mikld86/GMTiredandForked/README.md

<p align="center">

<br />
  

[][cc-by-nc-sa]
[][sonar-url]
[][sonar-url]
[][sonar-url]

</p>

This project upgrades a Gaggia espresso machine with smart controls to improve your coffee-making experience. By adding a display and custom electronics, you can monitor and control the machine more easily.

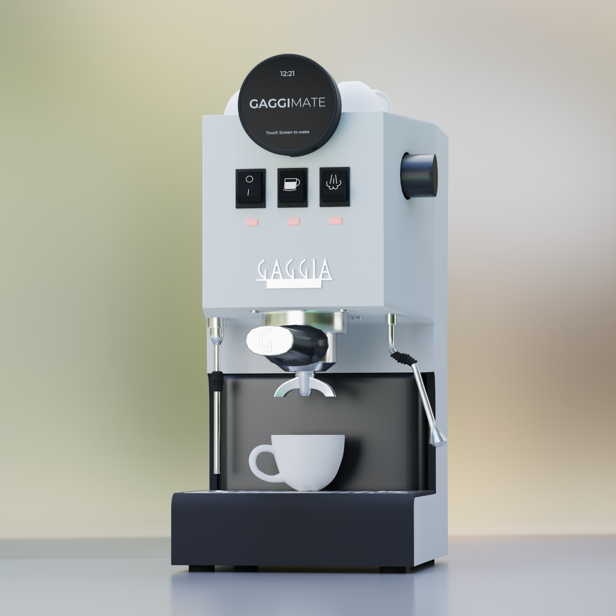
[picture p1: docs/assets/gaggimate-render.png]
Gaggia Classic Installation


## Features

- **Temperature Control**: Monitor the boiler temperature to ensure optimal brewing conditions.
- **Brew timer**: Set a target duration and run the brewing for the specific time.
- **Steam and Hot Water mode**: Control the pump and valve to run the respective task.
- **Safety Features**: Automatic shutoff if the system becomes unresponsive or overheats.
- **User Interface**: Simple, intuitive display to control and monitor the machine.

## Screenshots and Images

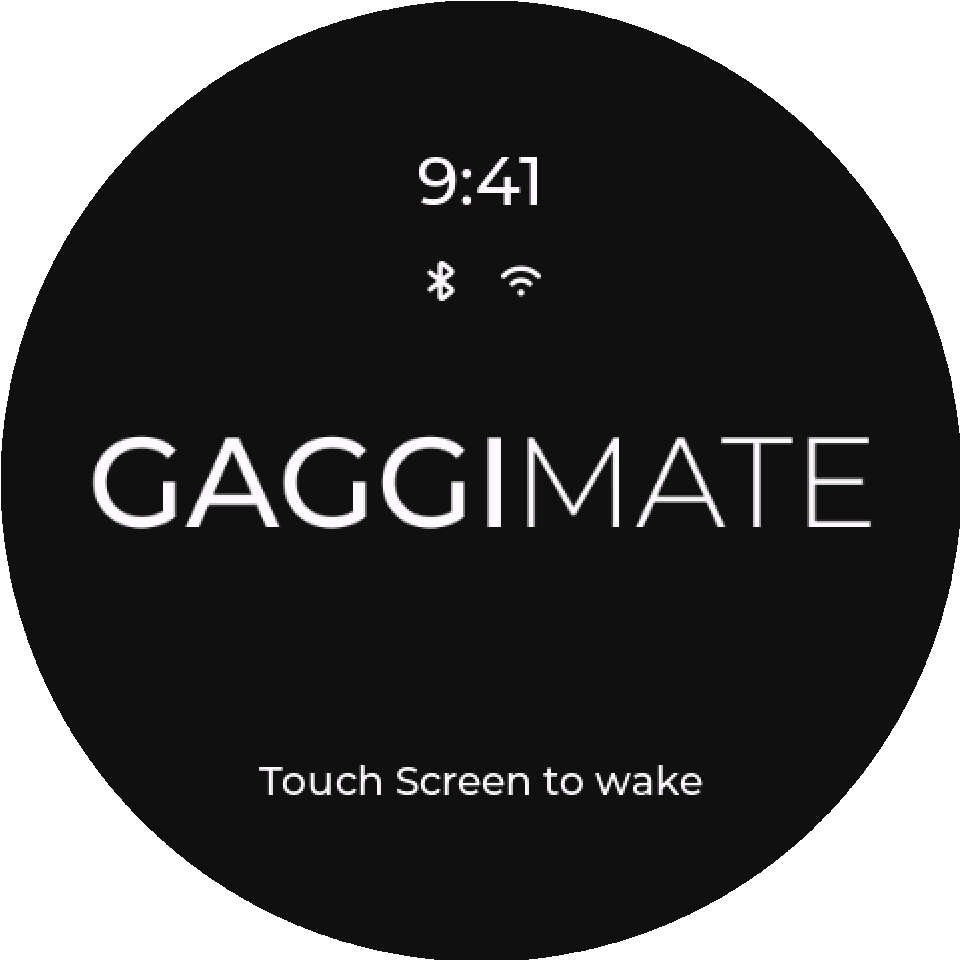
[picture p2: docs/assets/standby-screen.png]
Standby Screen

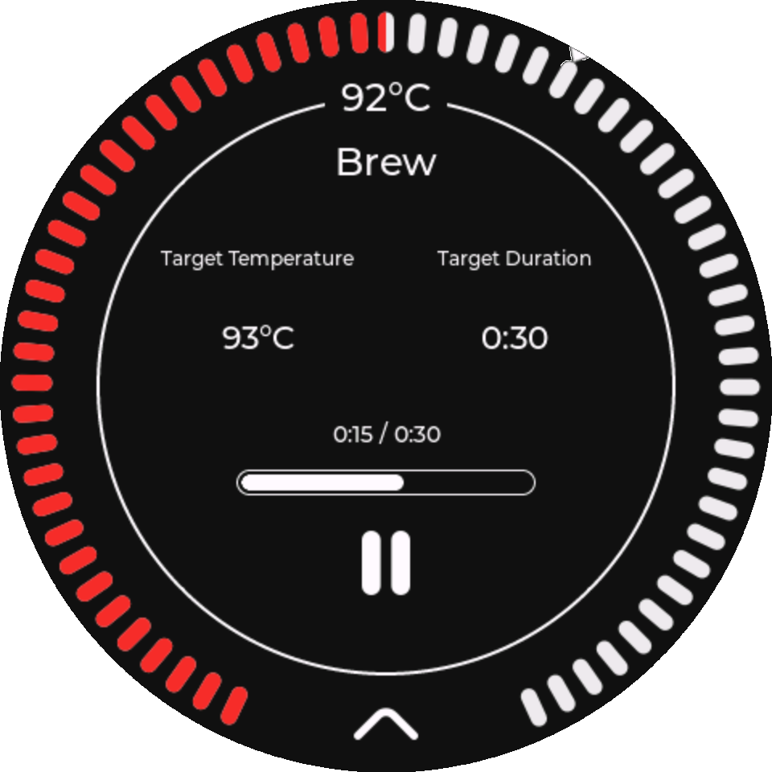
[picture p3: docs/assets/brew-screen.png]
Brew Screen

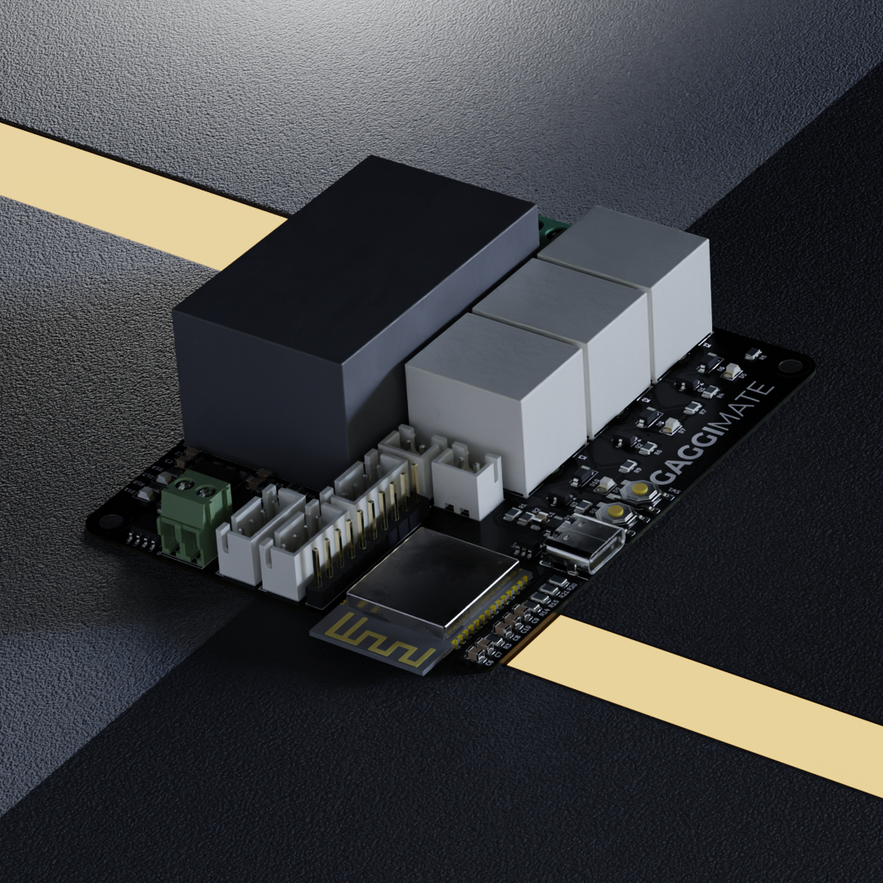
[picture p4: docs/assets/pcb_render.jpg]
PCB Render


### How to buy

The shop is now open for preorders and you can buy your kit on https://shop.gaggimate.eu/

## How It Works

The display allows you to control the espresso machine and see live temperature updates. If the machine becomes unresponsive or the temperature goes too high, it will automatically turn off for safety.

## Docs

The docs were moved to [https://gaggimate.eu/](https://gaggimate.eu/). You can find all sourcing and assembly information there.
Additional documentation for the WebSocket API can be found in [docs/websocket-api.yaml](docs/websocket-api.yaml).

## License

This work is licensed under CC BY-NC-SA 4.0. To view a copy of this license, visit https://creativecommons.org/licenses/by-nc-sa/4.0/

[sonar-violations]: https://img.shields.io/sonar/blocker_violations/jniebuhr_gaggimate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
[sonar-shield]: https://img.shields.io/sonar/quality_gate/jniebuhr_gaggimate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
[sonar-tech-debt]: https://img.shields.io/sonar/tech_debt/jniebuhr_gaggimate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
[sonar-url]: https://sonarcloud.io/project/overview?id=jniebuhr_gaggimate
[cc-by-nc-sa]: http://creativecommons.org/licenses/by-nc-sa/4.0/
[cc-by-nc-sa-image]: https://licensebuttons.net/l/by-nc-sa/4.0/88x31.png
[cc-by-nc-sa-shield]: https://img.shields.io/badge/License-CC%20BY--NC--SA%204.0-lightgrey.svg?style=for-the-badge
