mikld86/GMTiredandForked/docs/assets/gaggimate-transparent.png

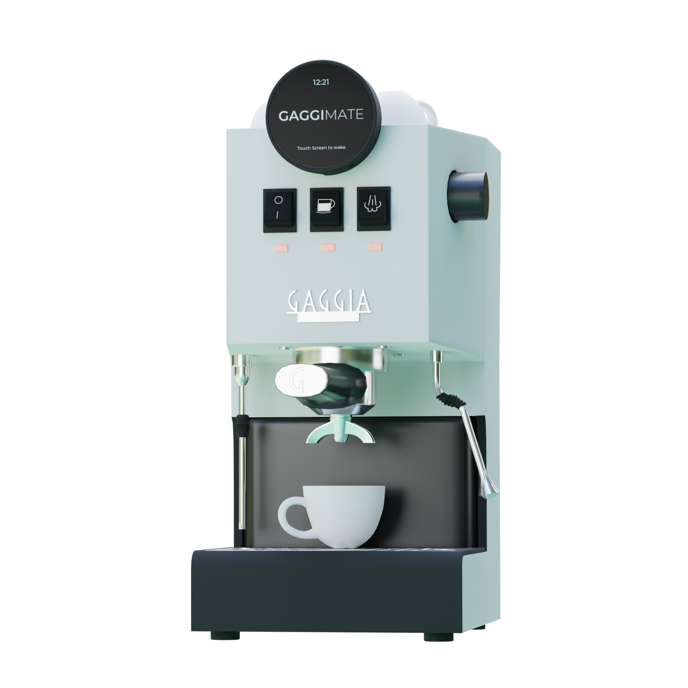
docs/assets/gaggimate-transparent.png
