mikld86/GMTiredandForked/docs/assets/menu-screen.png

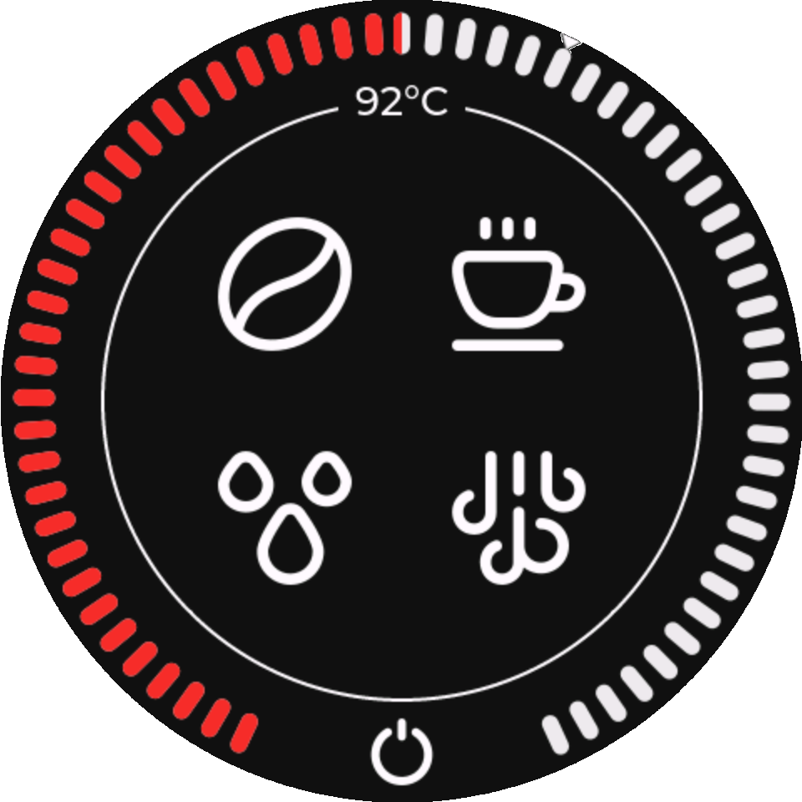
docs/assets/menu-screen.png
