mikld86/GMTiredandForked/docs/assets/pcb_top.png

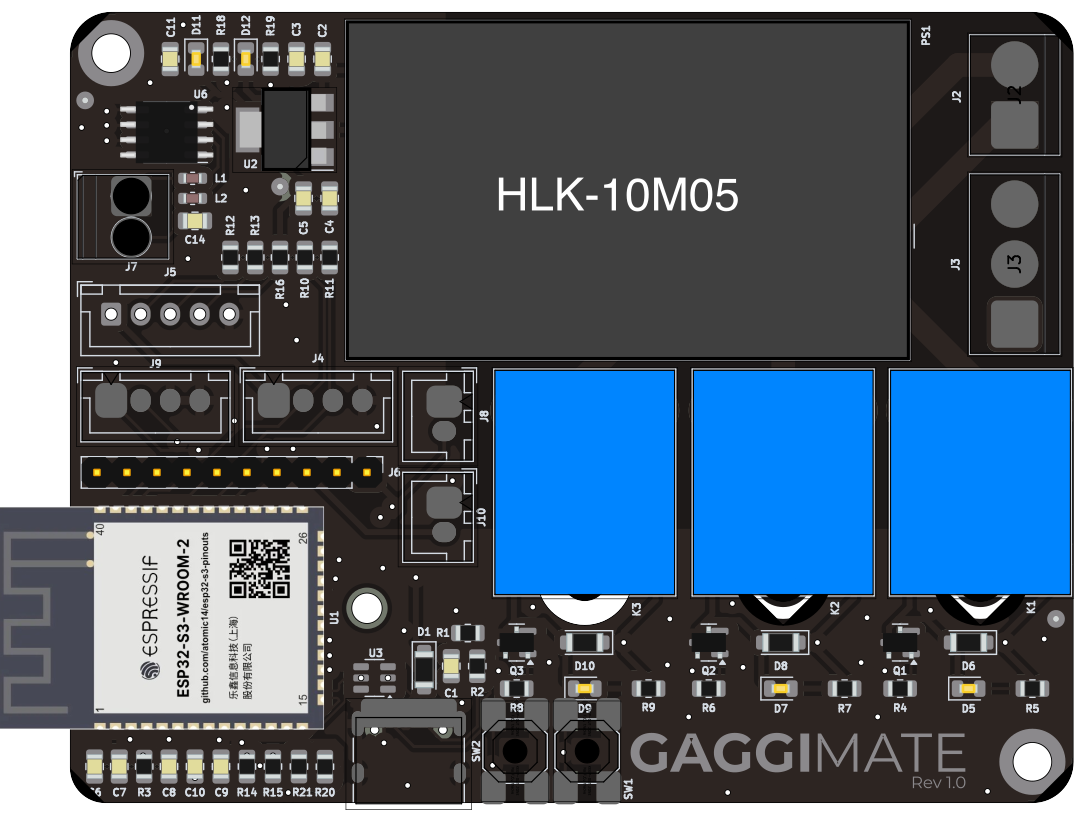
docs/assets/pcb_top.png
