mikld86/GMTiredandForked/docs/diagrams/classic.png

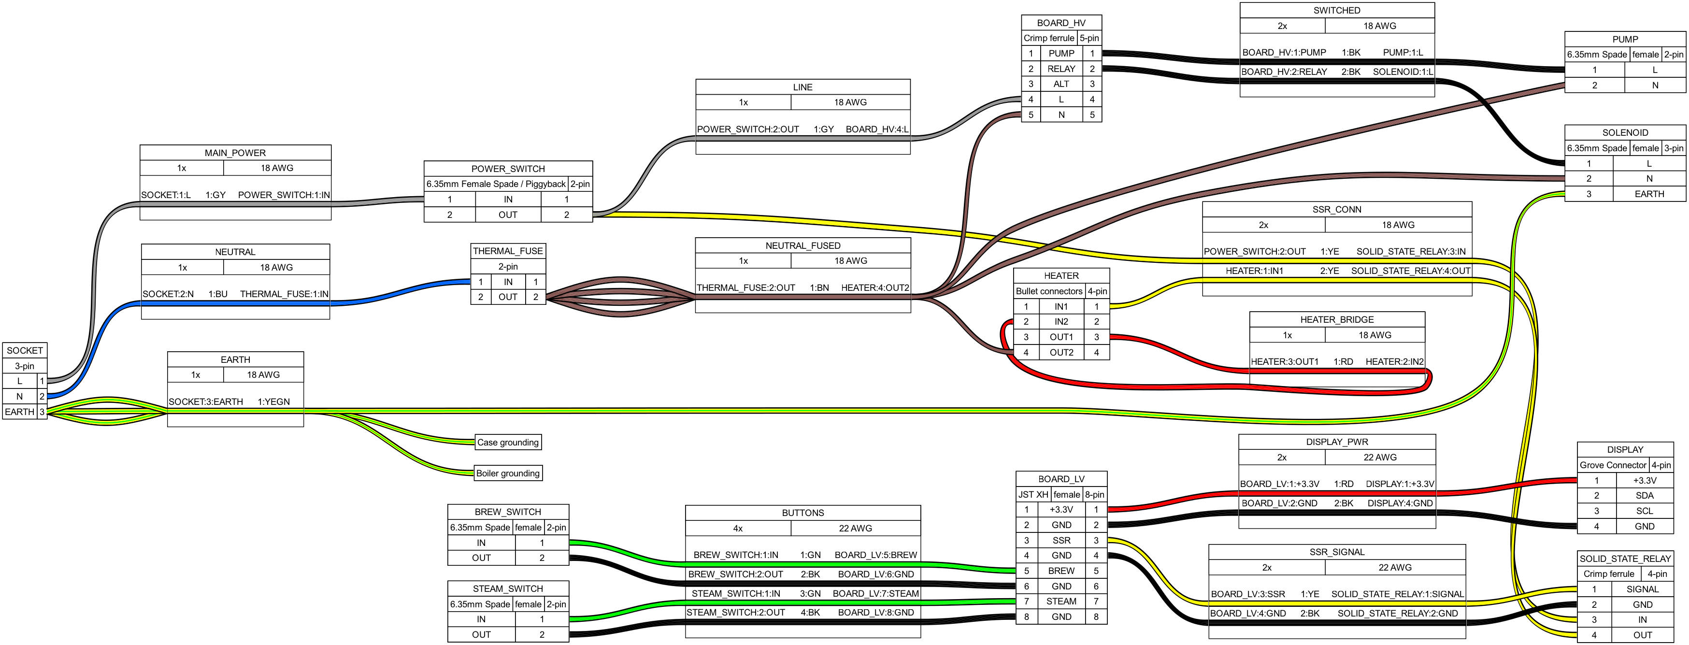
docs/diagrams/classic.png
