mikld86/GMTiredandForked/docs/diagrams/classicpro.png

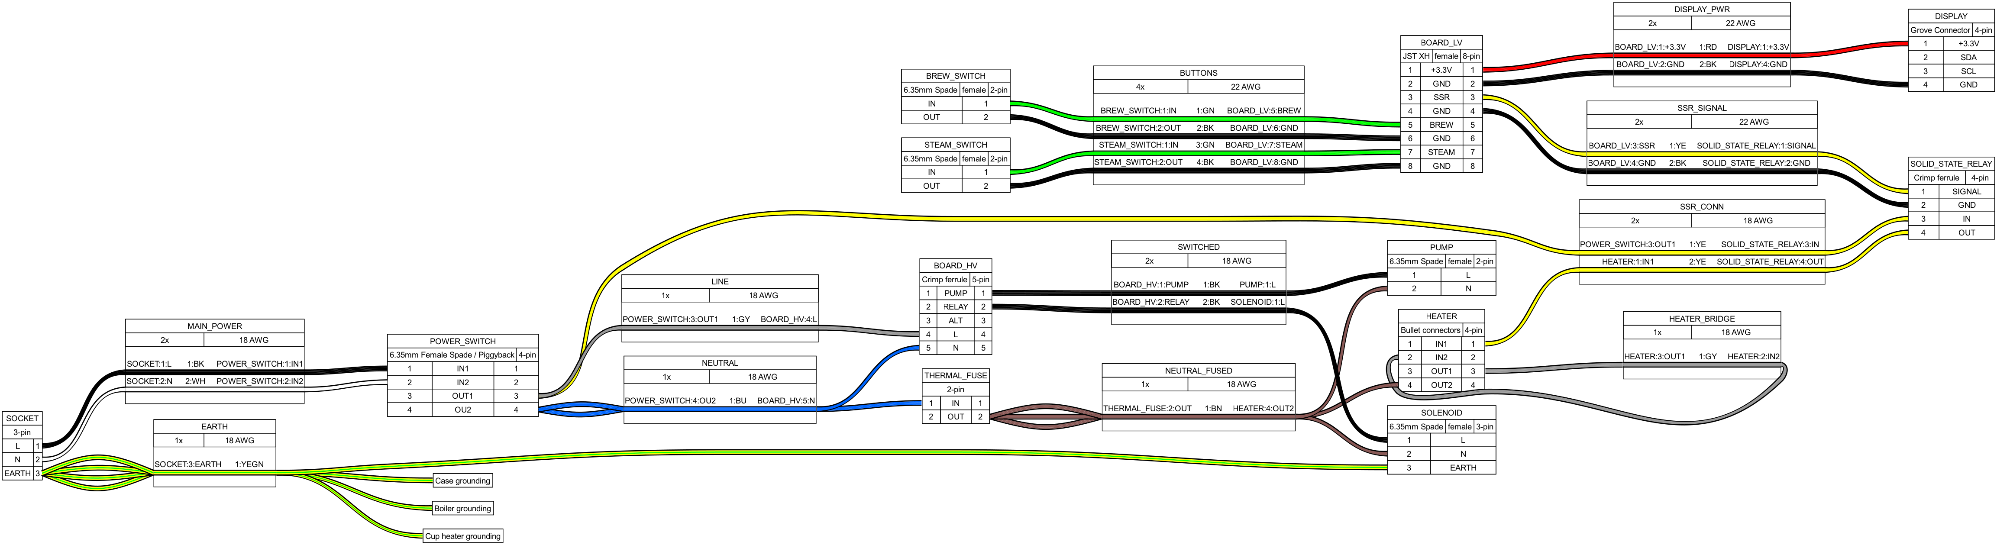
docs/diagrams/classicpro.png
