mikld86/GMTiredandForked/ui/assets/gauge-fill.png

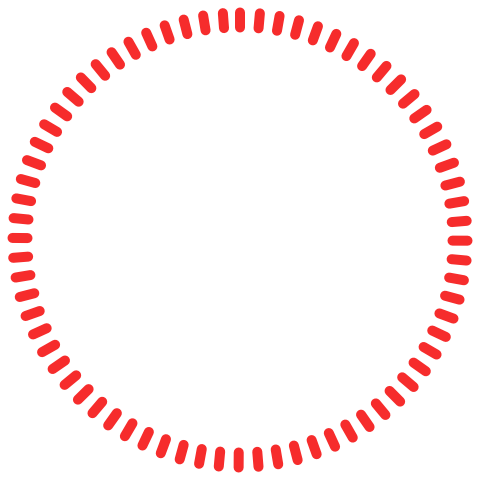
ui/assets/gauge-fill.png
