mikld86/GMTiredandForked/ui/assets/Untitled.png

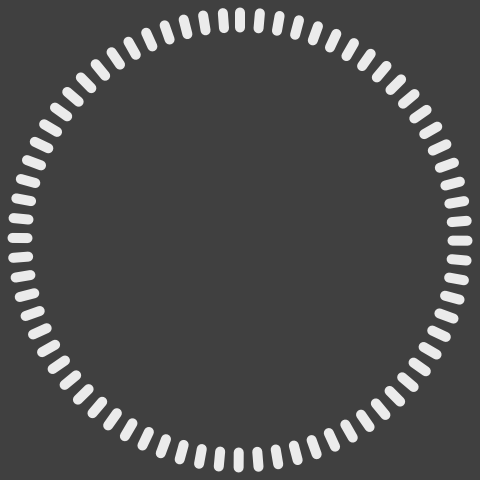
ui/assets/Untitled.png
