mikld86/GMTiredandForked/cad/Angled Display Case.step

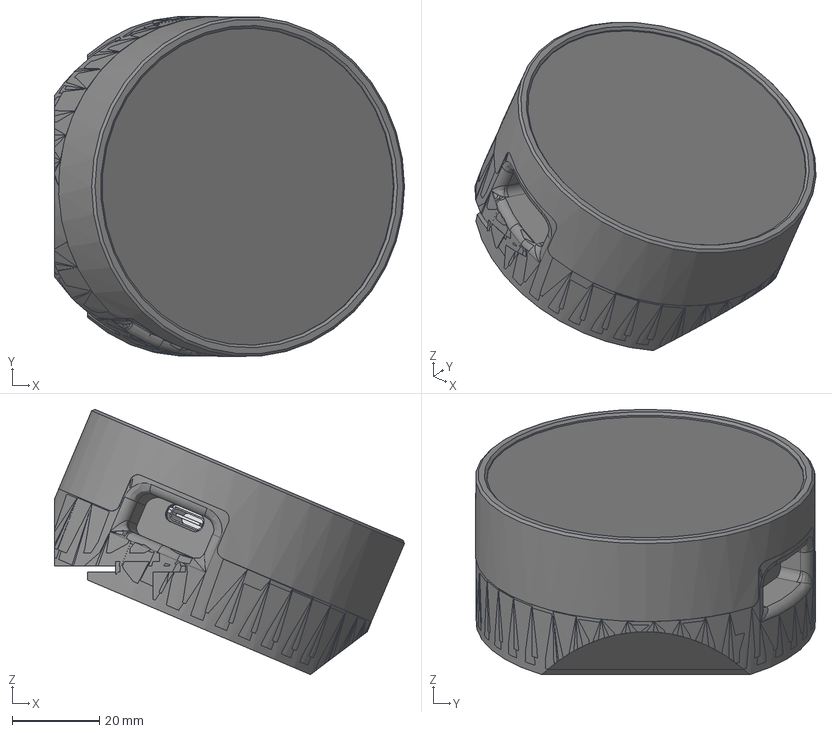
[picture p12: CAD file, 2025-01-10]
cad/Angled Display Case.step
80.1 x 77.9 x 60.7 mm
Case Front
Case Back Rancilio
LCD_BH021
T_RGB-V1_0
T_RGB_COVA
Case Back GCP
Case Back GC
