mikld86/GMTiredandForked/stls/display/case_back_rancilio_silvia.stl

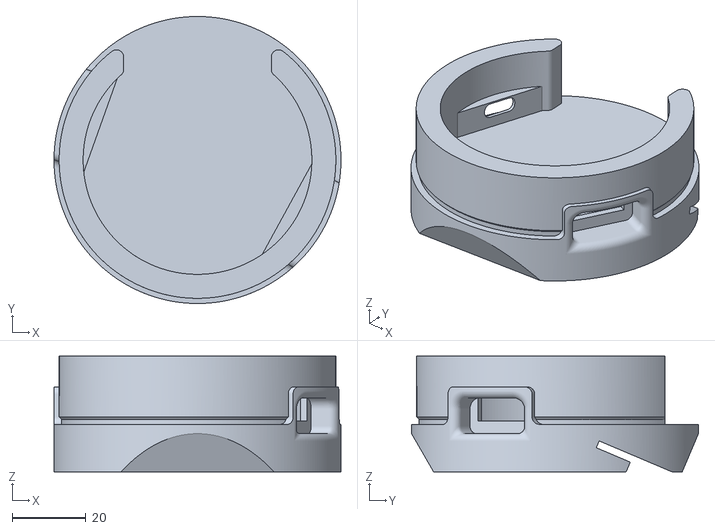
[picture p13: CAD file, 2025-04-02]
stls/display/case_back_rancilio_silvia.stl
77.8 x 77.8 x 31.4
