mikld86/GMTiredandForked/stls/lego/electronics_mount.stl

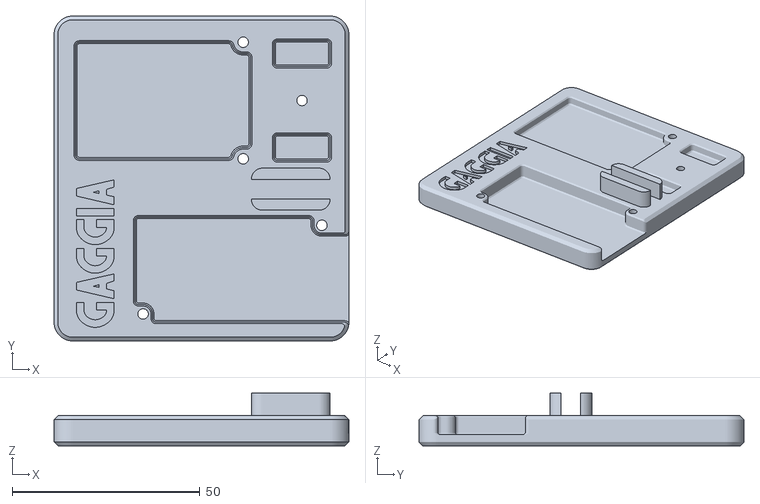
[picture p14: CAD file, 2024-11-18]
stls/lego/electronics_mount.stl
78.5 x 86.5 x 14.0
