mikld86/GMTiredandForked/stls/pcb/gaggimate-pro-rev1/pcb_cover_clipped_[support].stl

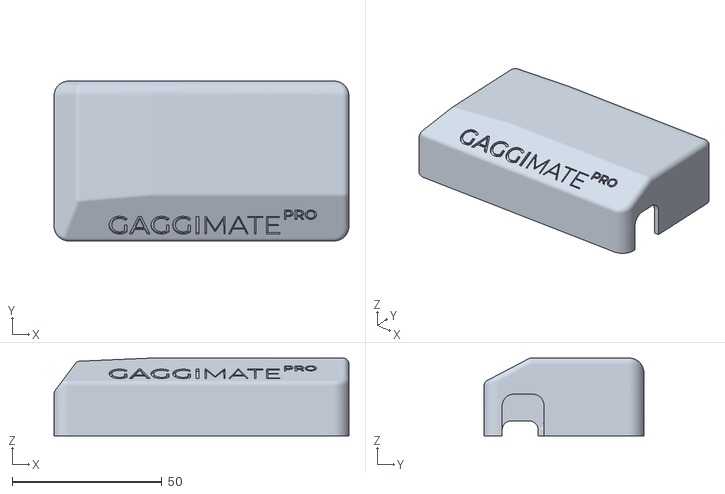
[picture p15: CAD file, 2025-04-22]
stls/pcb/gaggimate-pro-rev1/pcb_cover_clipped_[support].stl
98.4 x 53.4 x 26.0
