mikld86/GMTiredandForked/stls/pcb/gaggimate-standard-rev2/pcb_cover_clipped_[support].stl

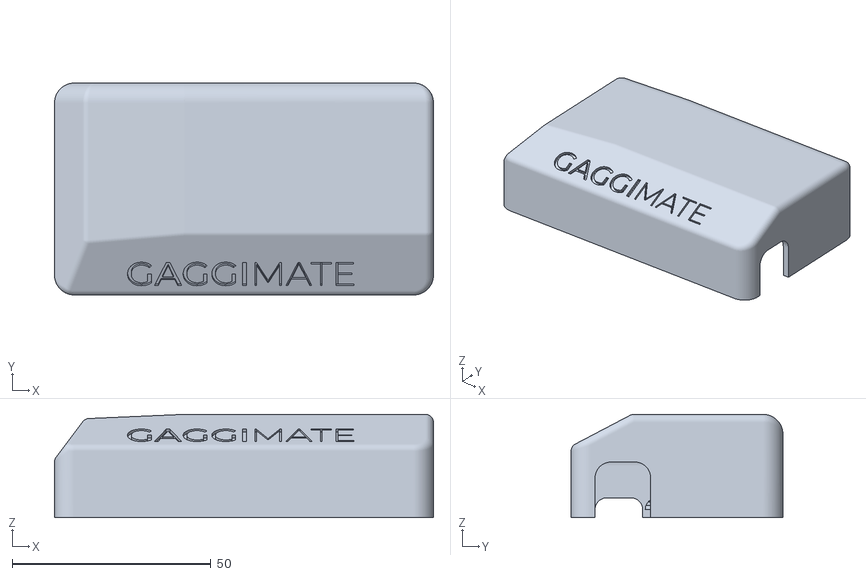
[picture p16: CAD file, 2025-04-22]
stls/pcb/gaggimate-standard-rev2/pcb_cover_clipped_[support].stl
95.4 x 53.4 x 26.0
