mikld86/GMTiredandForked/stls/display/case_front.stl

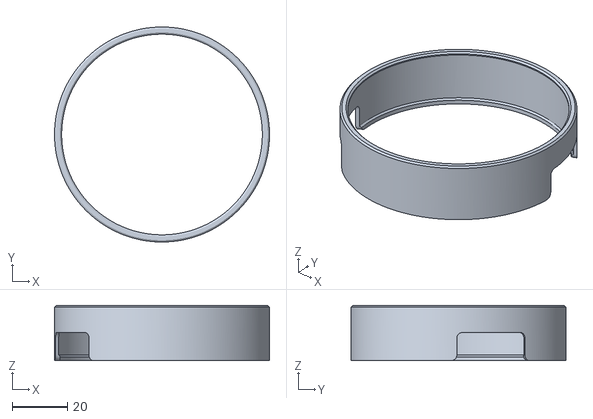
[picture p17: CAD file, 2025-04-02]
stls/display/case_front.stl
77.8 x 77.8 x 20.0
