mikld86/GMTiredandForked/stls/pcb/gaggimate-pro-rev1/pcb_base_clipped.stl

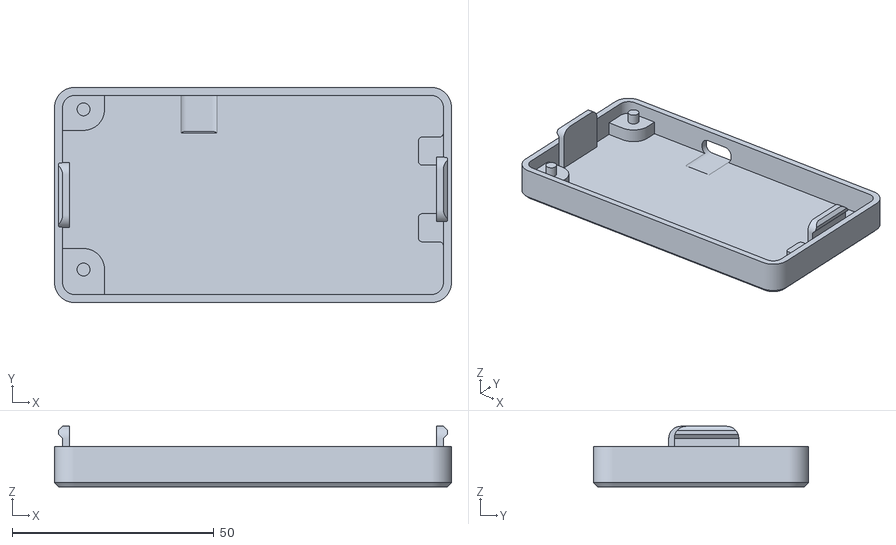
[picture p18: CAD file, 2025-04-22]
stls/pcb/gaggimate-pro-rev1/pcb_base_clipped.stl
98.4 x 53.4 x 15.0
