mikld86/GMTiredandForked/stls/pcb/gaggimate-standard-rev2/pcb_base_clipped.stl

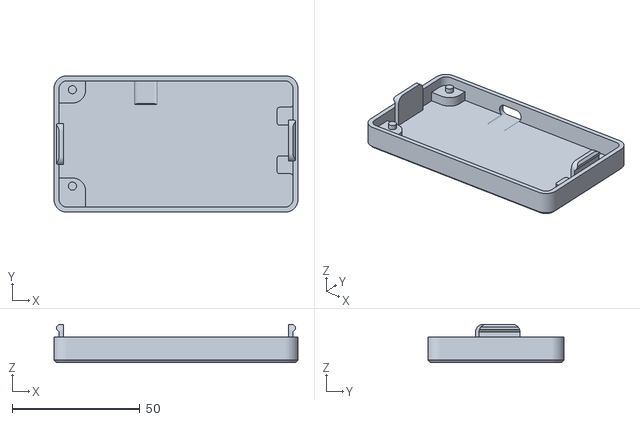
[picture p19: CAD file, 2025-04-22]
stls/pcb/gaggimate-standard-rev2/pcb_base_clipped.stl
95.4 x 53.4 x 15.0
