mikld86/GMTiredandForked/stls/display/Alternative backplate/case_back.stl

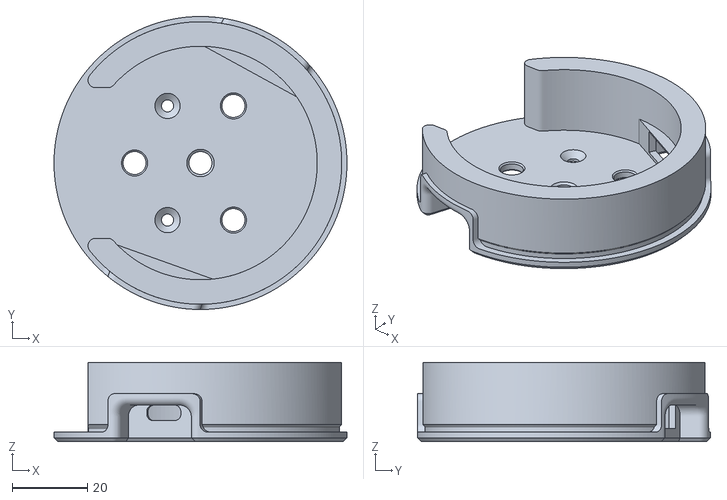
[picture p20: CAD file, 2024-11-18]
stls/display/Alternative backplate/case_back.stl
77.8 x 77.8 x 21.0
