mikld86/GMTiredandForked/stls/display/case_back_gaggia_classic_pro.stl

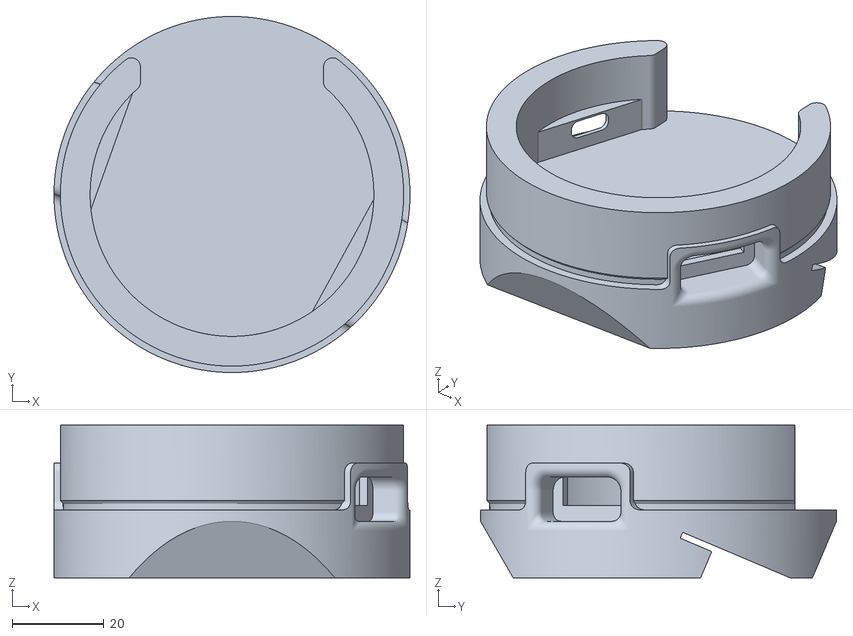
[picture p21: CAD file, 2025-04-02]
stls/display/case_back_gaggia_classic_pro.stl
77.8 x 77.8 x 33.4
