mikld86/GMTiredandForked/cad/Display Case.step

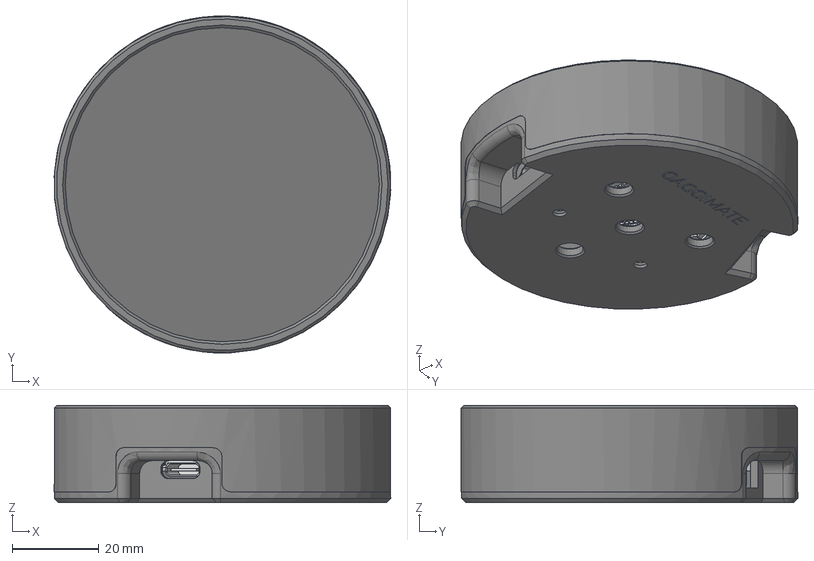
[picture p22: CAD file, 2024-11-26]
cad/Display Case.step
77.8 x 77.9 x 22.5 mm
Case Front
Case Back
LCD_BH021
T_RGB-V1_0
T_RGB_COVA
