mikld86/GMTiredandForked/stls/display/case_back_gaggia_classic.stl

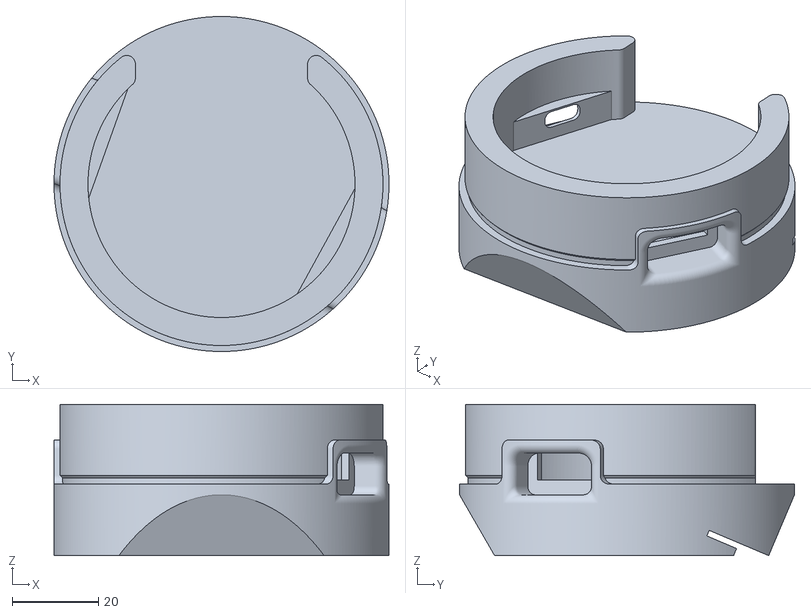
[picture p23: CAD file, 2025-04-02]
stls/display/case_back_gaggia_classic.stl
77.8 x 77.8 x 35.1
