mikld86/GMTiredandForked/stls/pcb/gaggimate-standard-rev1/pcb_clipped_cover.stl

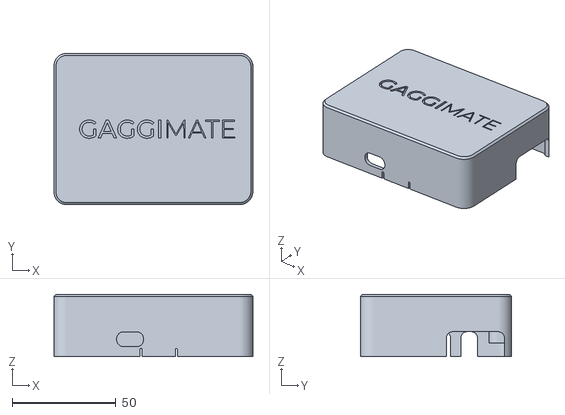
[picture p24: CAD file, 2024-12-03, an earlier design]
stls/pcb/gaggimate-standard-rev1/pcb_clipped_cover.stl
96.0 x 73.0 x 30.0
