mikld86/GMTiredandForked/stls/pcb/gaggimate-standard-rev1/pcb_clipped_base.stl

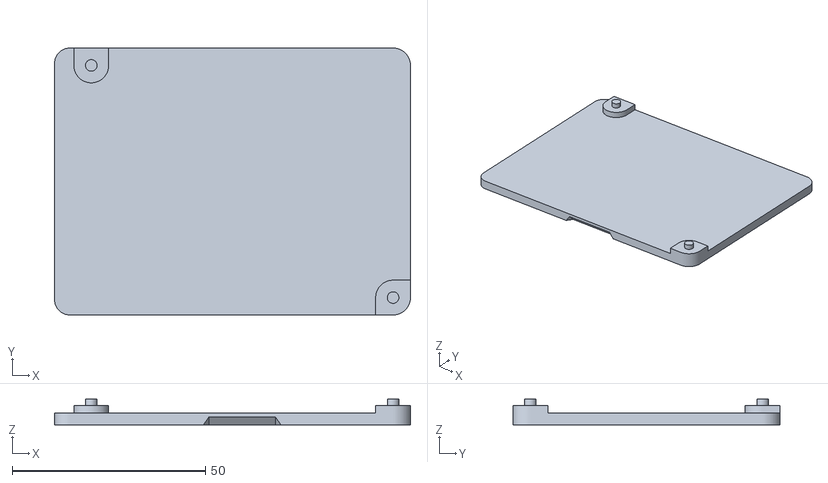
[picture p25: CAD file, 2024-12-03, an earlier design]
stls/pcb/gaggimate-standard-rev1/pcb_clipped_base.stl
92.0 x 69.0 x 6.60
