mikld86/GMTiredandForked/(list of files, cad)

Other CAD files:
stls/display/Alternative backplate/Case-back-withScrewholes.stl.stl
cad/Screen Backplate - no screwholes.step
stls/display/Alternative backplate/Case-back-noScrewholes.stl
cad/Screen Backplate - With screwholes.step
stls/pcb/gaggimate-standard-rev1/pcb_base.stl
stls/pcb/gaggimate-standard-rev1/pcb_cover.stl
