mikld86/GMTiredandForked/pcb/expansion-template/gaggimate-expansion-template.kicad_pcb

## KiCad design pcb/expansion-template/gaggimate-expansion-template.kicad_pcb (2025-02-04)

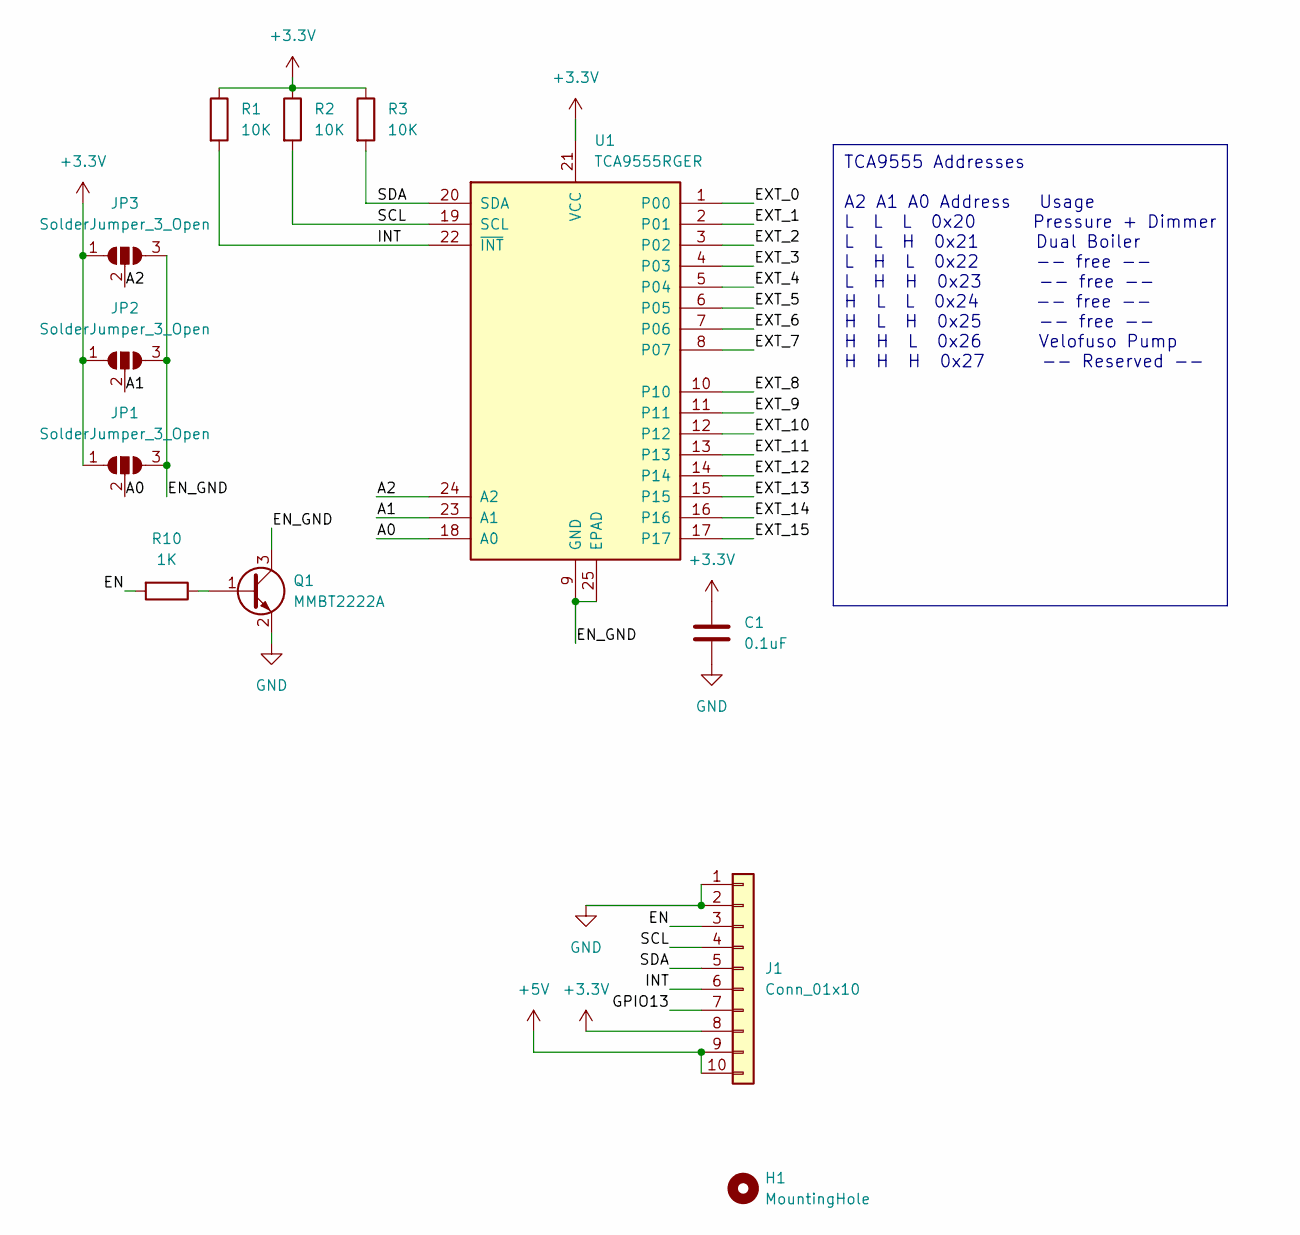
[picture p26: schematic gaggimate-expansion-template.kicad_sch]

Parts:
C1: 0.1uF; C_0603_1608Metric
H1: MountingHole; MountingHole_2.7mm_M2.5
J1: Conn_01x10; PinSocket_1x10_P2.54mm_Vertical
JP1, JP2, JP3: SolderJumper_3_Open; SolderJumper-3_P1.3mm_Open_RoundedPad1.0x1.5mm
Q1: MMBT2222A; SOT-23
R1, R2, R3: 10K; R_0603_1608Metric
R10: 1K; R_0603_1608Metric
U1: TCA9555RGER; VQFN-24-1EP_4x4mm_P0.5mm_EP2.45x2.45mm

Connections:
+3.3V: C1.1, J1.8, JP1.1 (A), JP2.1 (A), JP3.1 (A), R1.1, R2.1, R3.1, U1.21 (VCC)
+5V: J1.9, J1.10
/A0: JP1.2 (C), U1.18 (A0)
/A1: JP2.2 (C), U1.23 (A1)
/A2: JP3.2 (C), U1.24 (A2)
/EN: J1.3, R10.2
/EN_GND: JP1.3 (B), JP2.3 (B), JP3.3 (B), Q1.3 (C), U1.9 (GND), U1.25 (EPAD)
/EXT_0: U1.1 (P00)
/EXT_1: U1.2 (P01)
/EXT_2: U1.3 (P02)
/EXT_3: U1.4 (P03)
/EXT_4: U1.5 (P04)
/EXT_5: U1.6 (P05)
/EXT_6: U1.7 (P06)
/EXT_7: U1.8 (P07)
/EXT_8: U1.10
/EXT_9: U1.11
/EXT_10: U1.12
/EXT_11: U1.13
/EXT_12: U1.14
/EXT_13: U1.15
/EXT_14: U1.16
/EXT_15: U1.17
/GPIO13: J1.7
/INT: J1.6, R1.2, U1.22 (~INT)
/SCL: J1.4, R2.2, U1.19 (SCL)
/SDA: J1.5, R3.2, U1.20 (SDA)
GND: C1.2, J1.1, J1.2, Q1.2 (E)
unnamed: Q1.1 (B), R10.1

Notes on the sheet:
TCA9555 Addresses A2 A1 A0 Address Usage L L L 0x20 Pressure + Dimmer L L H 0x21 Dual Boiler L H L 0x22 -- free -- L H H 0x23 -- free -- H L L 0x24 -- free -- H L H 0x25 -- free -- H H L 0x26 Velofuso Pump H H H 0x27 -- Reserved --

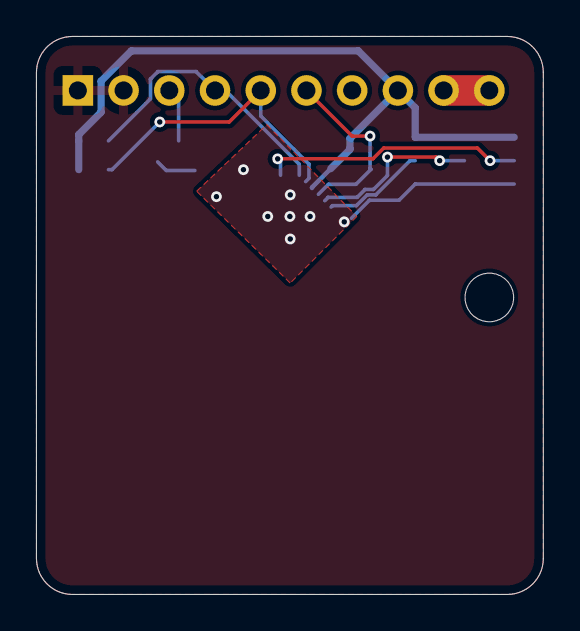
[picture p27: board gaggimate-expansion-template.kicad_pcb from above]

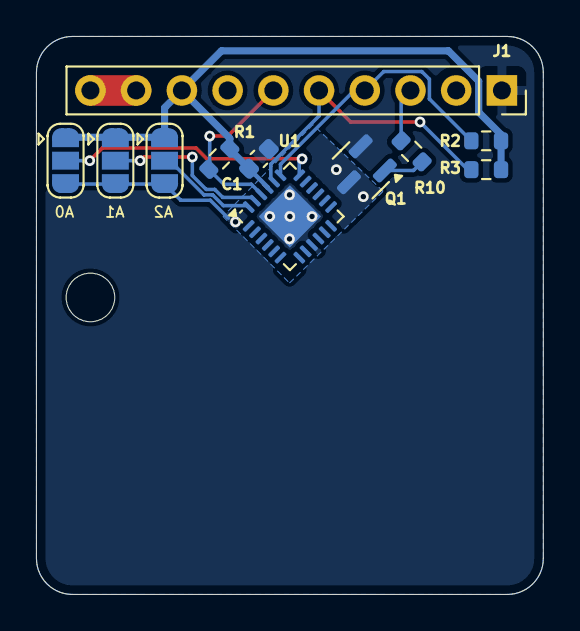
[picture p28: board gaggimate-expansion-template.kicad_pcb from below]

Board: 2 copper layers, 28.2 x 31.0 mm, 12 parts (11 on the bottom side), 12 nets.
