mikld86/GMTiredandForked/pcb/Gaggimate.kicad_pcb

## KiCad design pcb/Gaggimate.kicad_pcb (2024-11-24)

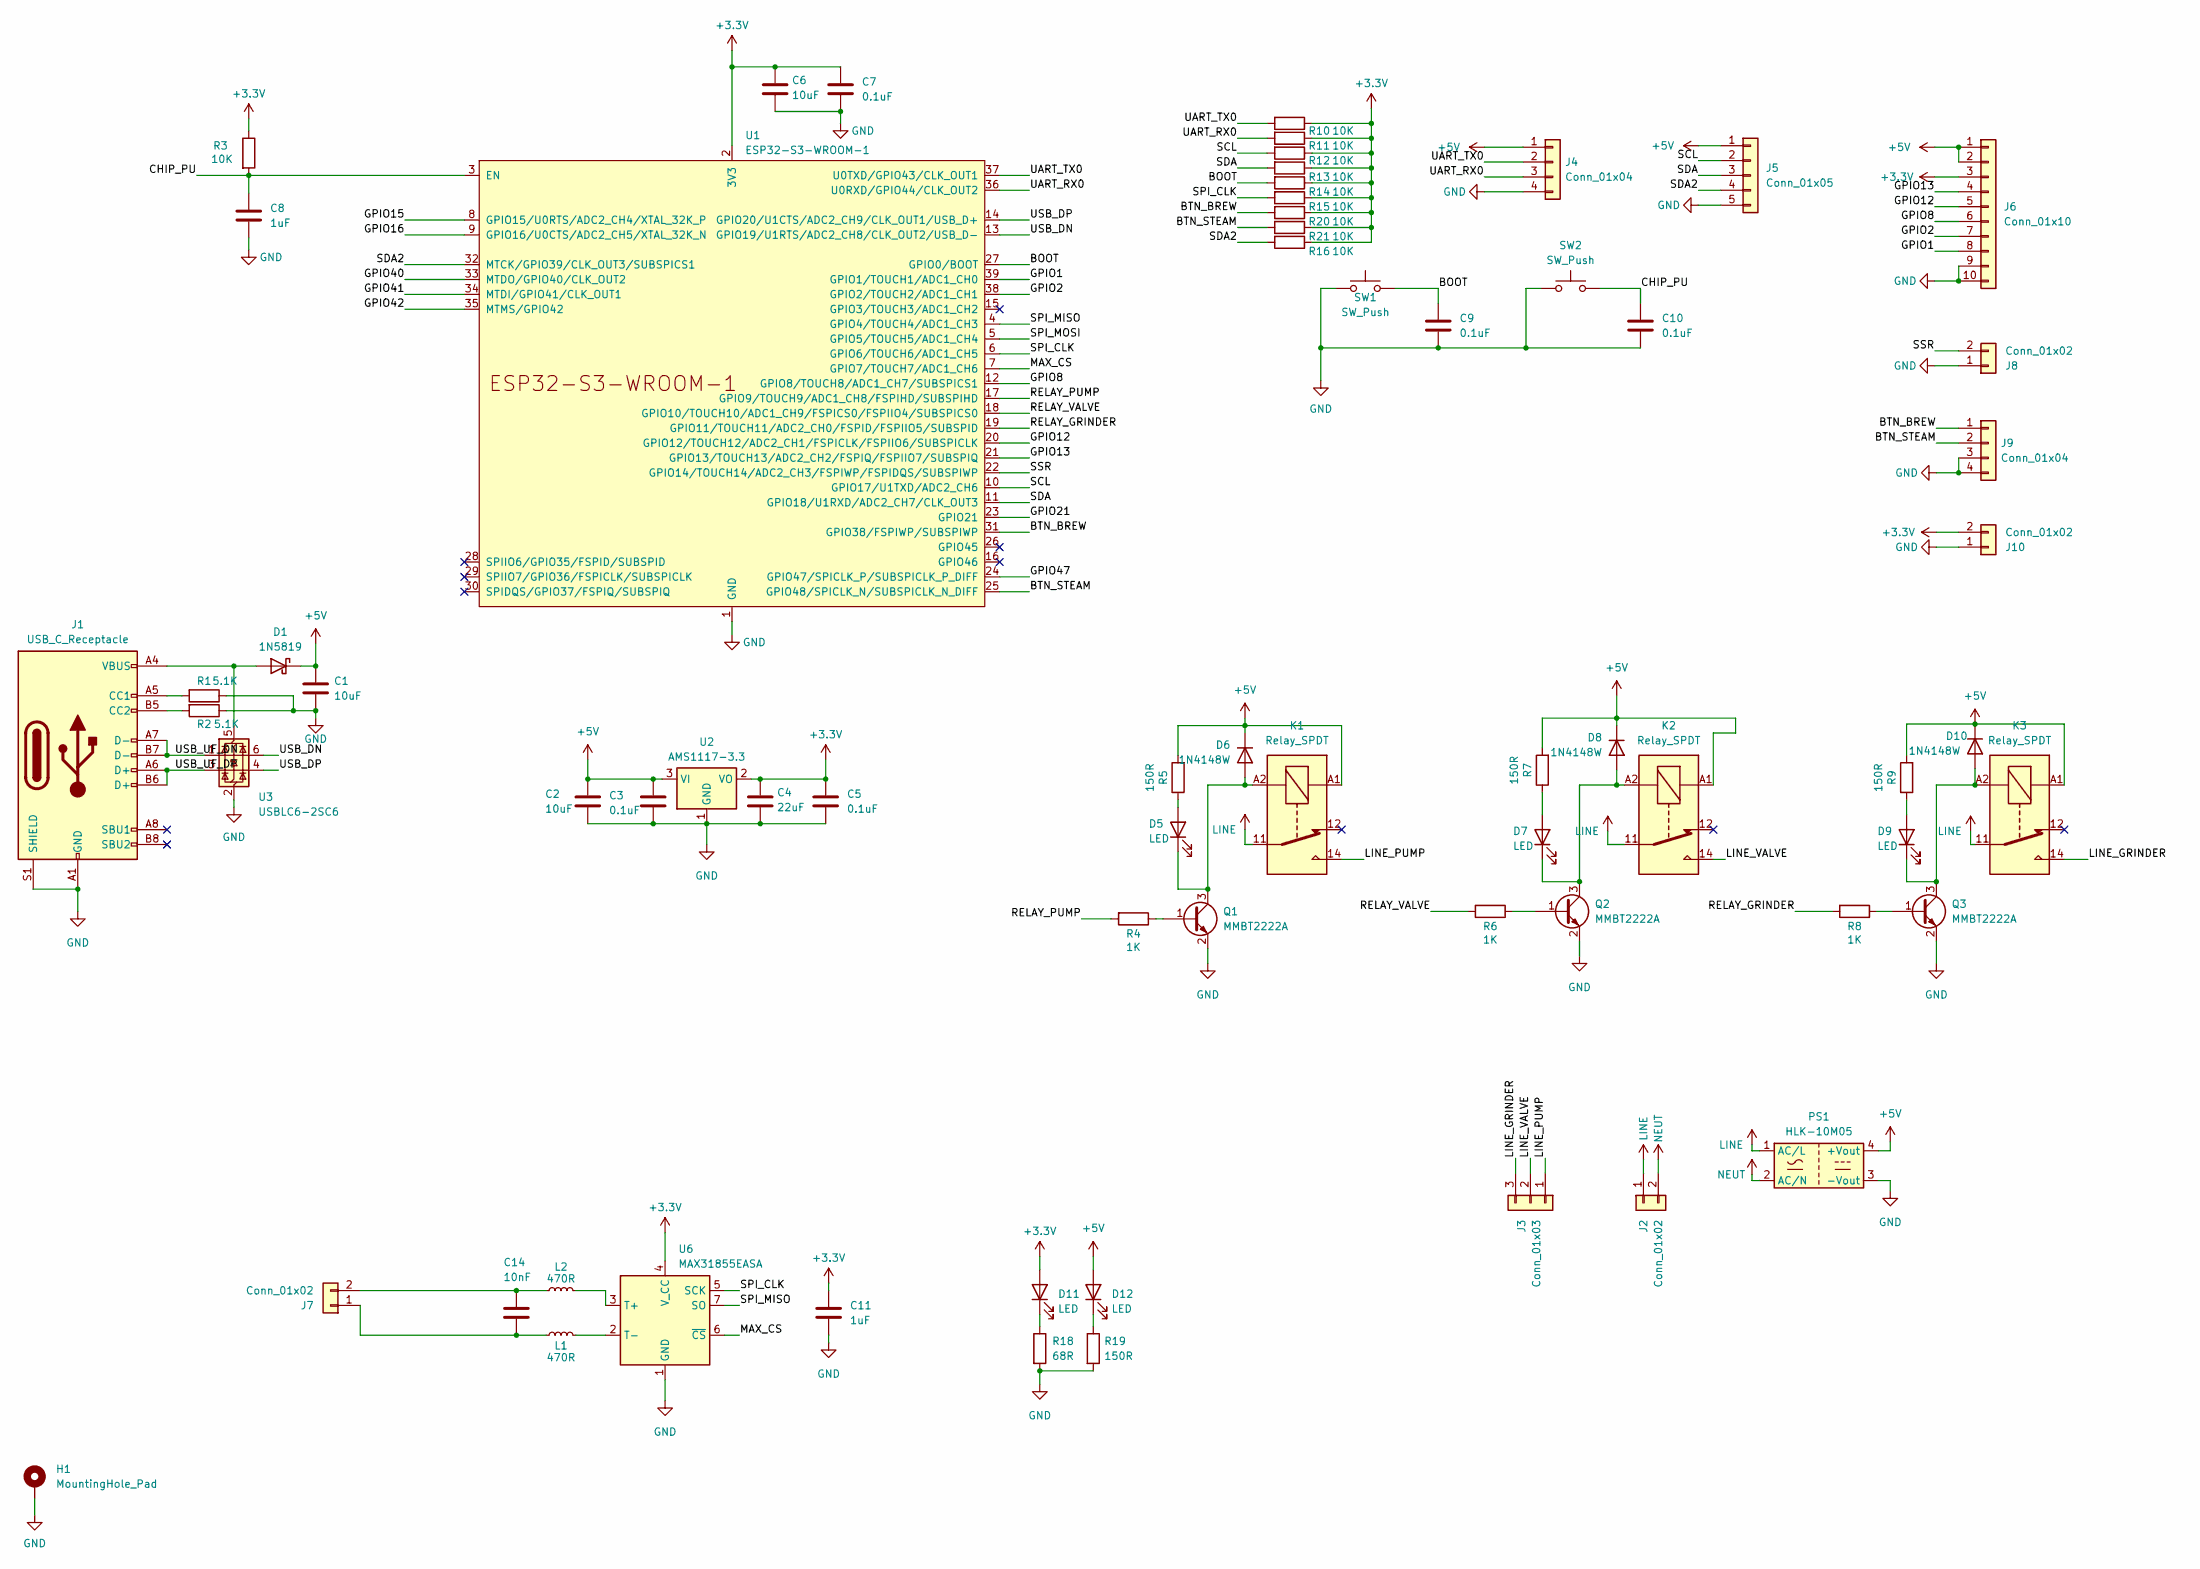
[picture p29: schematic Gaggimate.kicad_sch, GaggiMate Controller PCB]

Parts:
C1, C2, C6: 10uF; C_0805_2012Metric; LCSC C15850
C3, C5, C7, C9, C10: 0.1uF; C_0805_2012Metric; LCSC C49678
C4: 22uF; C_0805_2012Metric; LCSC C45783
C8, C11: 1uF; C_0805_2012Metric; LCSC C28323
C14: 10nF; C_0805_2012Metric; LCSC C1710
D1: 1N5819; D_SOD-123; LCSC C2891704
D5, D7, D9, D11, D12: LED; LED_0805_2012Metric; LCSC C84256
D6, D8, D10: 1N4148W; D_SOD-123; LCSC C81598
H1: MountingHole_Pad; MountingHole_3.2mm_M3_DIN965_Pad_TopBottom
J1: USB_C_Receptacle; USB_C_Receptacle_HRO_TYPE-C-31-M-12; LCSC C165948
J2: Conn_01x02; TerminalBlock_bornier-2_P5.08mm; LCSC C409161
J3: Conn_01x03; TerminalBlock_bornier-3_P5.08mm; LCSC C409163
J4, J9: Conn_01x04; JST_XH_B4B-XH-A_1x04_P2.50mm_Vertical; LCSC C144395
J5: Conn_01x05; JST_XH_B5B-XH-A_1x05_P2.50mm_Vertical
J6: Conn_01x10; PinHeader_1x10_P2.54mm_Vertical; LCSC C5383117
J7: Conn_01x02; TerminalBlock_Phoenix_PT-1,5-2-3.5-H_1x02_P3.50mm_Horizontal; LCSC C415432
J8, J10: Conn_01x02; JST_XH_B2B-XH-A_1x02_P2.50mm_Vertical; LCSC C158012
K1, K2, K3: Relay_SPDT; Relay_SPDT_Finder_36.11; LCSC C35449
L1, L2: 470R; L_0603_1608Metric; LCSC C413961
PS1: HLK-10M05; Converter_ACDC_HiLink_HLK-10Mxx; LCSC C403745
Q1, Q2, Q3: MMBT2222A; SOT-23; LCSC C916372
R1, R2: 5.1K; R_0805_2012Metric; LCSC C27834
R3, R10, R11, R12, R13, R14, R15, R16, R20, R21: 10K; R_0805_2012Metric; LCSC C17414
R4, R6, R8: 1K; R_0805_2012Metric; LCSC C17513
R5, R7, R9, R19: 150R; R_0805_2012Metric; LCSC C17471
R18: 68R; R_0805_2012Metric; LCSC C17802
SW1, SW2: SW_Push; SW_SPST_SKQG_WithStem; LCSC C116647
U1: ESP32-S3-WROOM-1; LCSC C2913201
U2: AMS1117-3.3; SOT-223-3_TabPin2; LCSC C6186
U3: USBLC6-2SC6; SOT-23-6; LCSC C2827654
U6: MAX31855EASA; SOIC-8_3.9x4.9mm_P1.27mm; LCSC C52028

Connections:
+3.3V: C4.1, C5.1, C6.1, C7.1, C11.1, D11.2 (A), J6.3, J10.2, R3.1, R10.1, R11.1, R12.1, R13.1, R14.1, R15.1, R16.1, R20.1, R21.1, U1.2 (3V3), U2.2 (VO), U6.4 (V_CC)
+5V: C1.1, C2.1, C3.1, D1.1 (K), D6.1 (K), D8.1 (K), D10.1 (K), D12.2 (A), J4.1, J5.1, J6.1, J6.2, K1.A1, K2.A1, K3.A1, PS1.4 (+Vout), R5.2, R7.2, R9.2, U2.3 (VI)
/BOOT: C9.1, R14.2, SW1.2, U1.27 (GPIO0/BOOT)
/BTN_BREW: J9.1, R20.2, U1.31 (GPIO38/FSPIWP/SUBSPIWP)
/BTN_STEAM: J9.2, R21.2, U1.25 (GPIO48/SPICLK_N/SUBSPICLK_N_DIFF)
/CHIP_PU: C8.1, C10.1, R3.2, SW2.2, U1.3 (EN)
/GPIO1: J6.8, U1.39 (GPIO1/TOUCH1/ADC1_CH0)
/GPIO2: J6.7, U1.38 (GPIO2/TOUCH2/ADC1_CH1)
/GPIO8: J6.6, U1.12 (GPIO8/TOUCH8/ADC1_CH7/SUBSPICS1)
/GPIO12: J6.5, U1.20 (GPIO12/TOUCH12/ADC2_CH1/FSPICLK/FSPIIO6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)
/GPIO13: J6.4, U1.21 (GPIO13/TOUCH13/ADC2_CH2/FSPIQ/FSPIIO7/S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)
/GPIO15: U1.8 (GPIO15/U0RTS/ADC2_CH4/XTAL_32K_P)
/GPIO16: U1.9 (GPIO16/U0CTS/ADC2_CH5/XTAL_32K_N)
/GPIO21: U1.23 (GPIO21)
/GPIO40: U1.33 (MTDO/GPIO40/CLK_OUT2)
/GPIO41: U1.34 (MTDI/GPIO41/CLK_OUT1)
/GPIO42: U1.35 (MTMS/GPIO42)
/GPIO47: U1.24 (GPIO47/SPICLK_P/SUBSPICLK_P_DIFF)
/LINE_GRINDER: J3.3, K3.14
/LINE_PUMP: J3.1, K1.14
/LINE_VALVE: J3.2, K2.14
/MAX_CS: U1.7 (GPIO7/TOUCH7/ADC1_CH6), U6.6 (~CS)
/RELAY_GRINDER: R8.2, U1.19 (GPIO11/TOUCH11/ADC2_CH0/FSPID/FSPIIO5/S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)
/RELAY_PUMP: R4.2, U1.17 (GPIO9/TOUCH9/ADC1_CH8/FSPIHD/SUBSPIHD)
/RELAY_VALVE: R6.2, U1.18 (GPIO10/TOUCH10/ADC1_CH9/FSPICS0/FSPIIO4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)
/SCL: J5.2, R12.2, U1.10 (GPIO17/U1TXD/ADC2_CH6)
/SDA: J5.3, R13.2, U1.11 (GPIO18/U1RXD/ADC2_CH7/CLK_OUT3)
/SDA2: J5.4, R16.2, U1.32 (MTCK/GPIO39/CLK_OUT3/SUBSPICS1)
/SPI_CLK: R15.2, U1.6 (GPIO6/TOUCH6/ADC1_CH5), U6.5 (SCK)
/SPI_MISO: U1.4 (GPIO4/TOUCH4/ADC1_CH3), U6.7 (SO)
/SPI_MOSI: U1.5 (GPIO5/TOUCH5/ADC1_CH4)
/SSR: J8.2, U1.22 (GPIO14/TOUCH14/ADC2_CH3/FSPIWP/FSPIDQS/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)
/UART_RX0: J4.3, R11.2, U1.36 (U0RXD/GPIO44/CLK_OUT2)
/UART_TX0: J4.2, R10.2, U1.37 (U0TXD/GPIO43/CLK_OUT1)
/USB_DN: U1.13 (GPIO19/U1RTS/ADC2_CH8/CLK_OUT2/USB_D-), U3.6 (I/O1)
/USB_DP: U1.14 (GPIO20/U1CTS/ADC2_CH9/CLK_OUT1/USB_D+), U3.4 (I/O2)
/USB_UF_DN: J1.A7 (D-), J1.B7 (D-), U3.1 (I/O1)
/USB_UF_DP: J1.A6 (D+), J1.B6 (D+), U3.3 (I/O2)
GND: C1.2, C2.2, C3.2, C4.2, C5.2, C6.2, C7.2, C8.2, C9.2, C10.2, C11.2, H1.1, J1.A1 (GND), J1.A12 (GND), J1.B1 (GND), J1.B12 (GND), J1.S1 (SHIELD), J4.4, J5.5, J6.9, J6.10, J8.1, J9.3, J9.4, J10.1, PS1.3 (-Vout), Q1.2 (E), Q2.2 (E), Q3.2 (E), R1.1, R2.1, R18.2, R19.2, SW1.1, SW2.1, U1.1 (GND), U1.40 (GND), U1.41 (GND), U2.1 (GND), U3.2 (GND), U6.1 (GND); also elsewhere on the board
LINE: J2.1, K1.11, K2.11, K3.11, PS1.1 (AC/L)
NEUT: J2.2, PS1.2 (AC/N)
unnamed: D1.2 (A), J1.A4 (VBUS), J1.A9 (VBUS), J1.B4 (VBUS), J1.B9 (VBUS), U3.5 (VBUS)
unnamed: D5.2 (A), R5.1
unnamed: D5.1 (K), D6.2 (A), K1.A2, Q1.3 (C)
unnamed: D7.2 (A), R7.1
unnamed: D7.1 (K), D8.2 (A), K2.A2, Q2.3 (C)
unnamed: D9.2 (A), R9.1
unnamed: D9.1 (K), D10.2 (A), K3.A2, Q3.3 (C)
unnamed: D11.1 (K), R18.1
unnamed: D12.1 (K), R19.1
unnamed: J1.A5 (CC1), R1.2
unnamed: J1.B5 (CC2), R2.2
unnamed: C14.2, J7.1, L1.1
unnamed: C14.1, J7.2, L2.1
unnamed: Q1.1 (B), R4.1
unnamed: Q2.1 (B), R6.1
unnamed: Q3.1 (B), R8.1
unnamed: L2.2, U6.3 (T+)
unnamed: L1.2, U6.2 (T-)

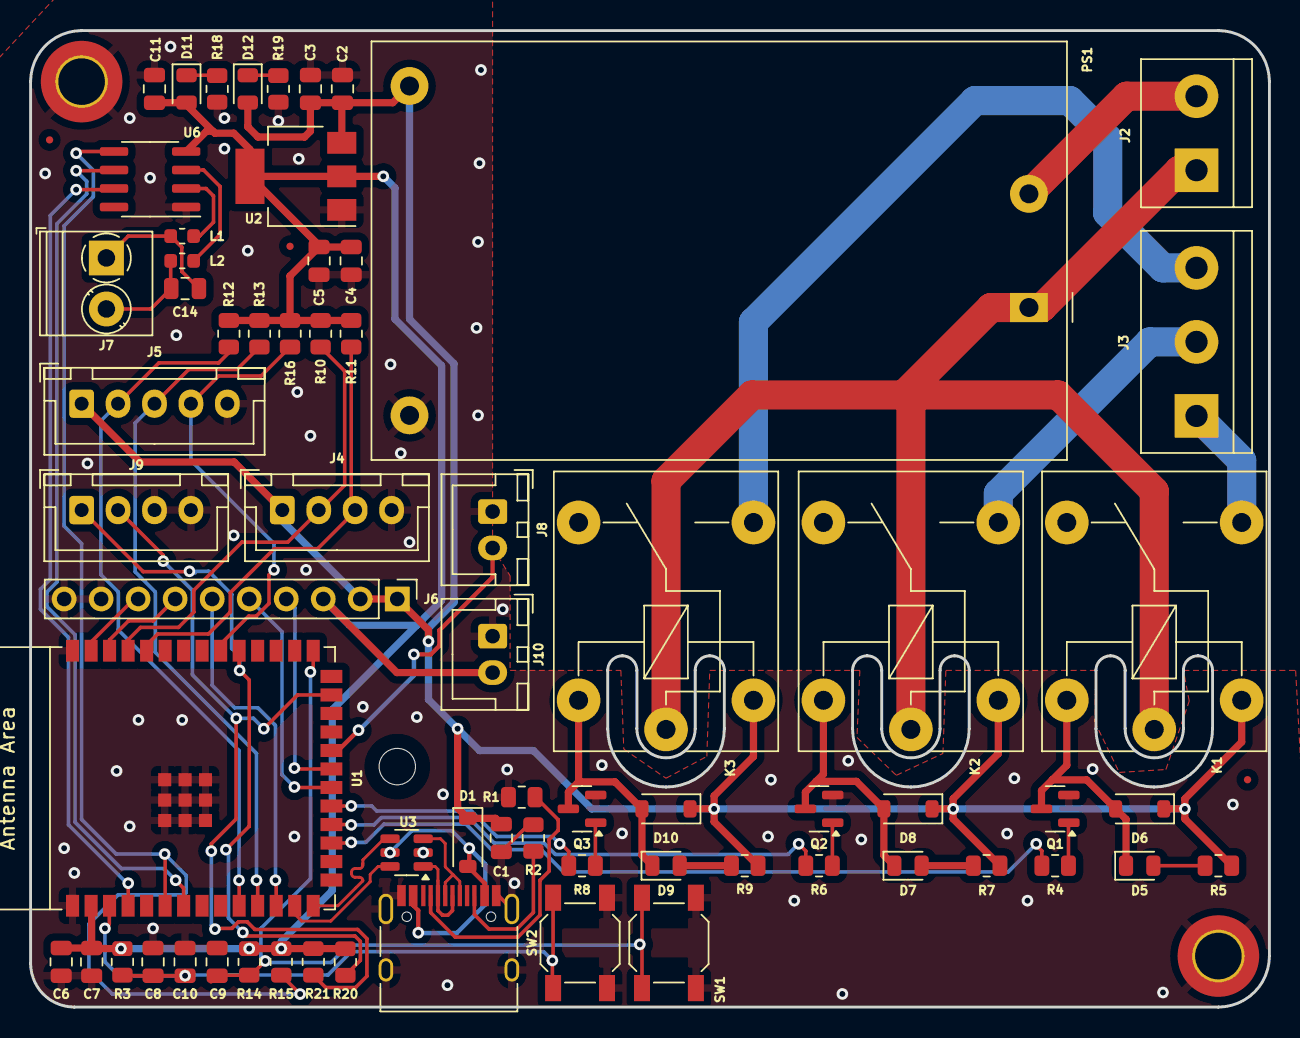
[picture p30: board Gaggimate.kicad_pcb from above]

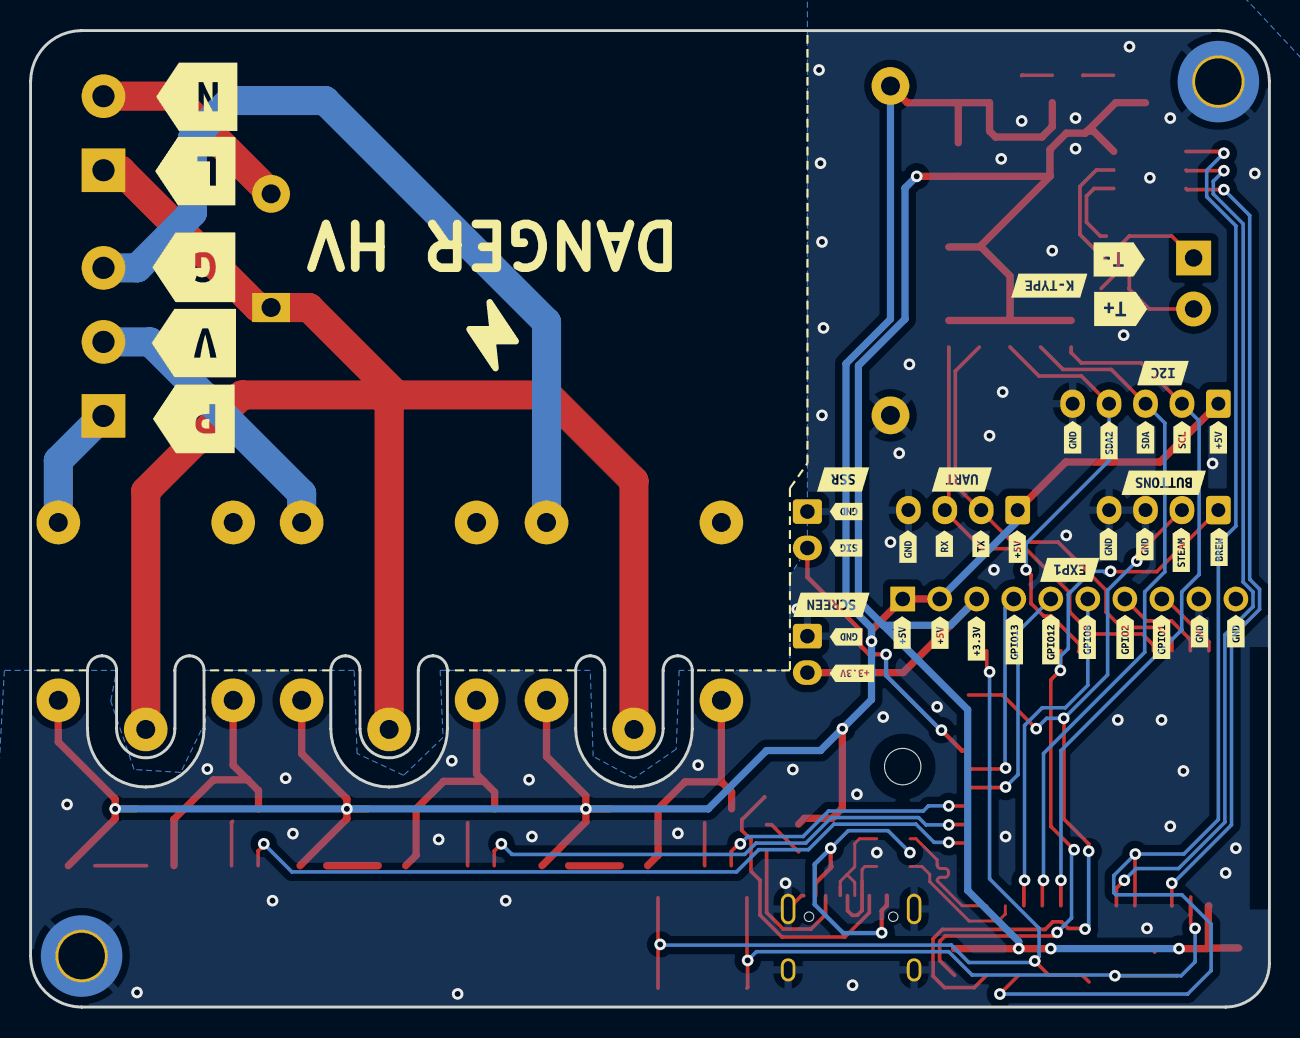
[picture p31: board Gaggimate.kicad_pcb from below]

Board: 2 copper layers, 85.0 x 67.0 mm, 109 parts (41 on the bottom side), 51 nets.

Other parts of the board:
H1#2: MountingHole_Pad; MountingHole_3.2mm_M3_DIN965_Pad_TopBottom
kibuzzard-6735A9F6: G***; kibuzzard-6735A9F6
kibuzzard-6735A9FB: G***; kibuzzard-6735A9FB
kibuzzard-67426AC2: G***; kibuzzard-67426AC2
kibuzzard-673226A0: G***; kibuzzard-673226A0
kibuzzard-673226A8: G***; kibuzzard-673226A8
kibuzzard-673226AF, kibuzzard-673226AF#2: G***; kibuzzard-673226AF
kibuzzard-673226B7: G***; kibuzzard-673226B7
kibuzzard-673226BE: G***; kibuzzard-673226BE
kibuzzard-673226D2: G***; kibuzzard-673226D2
kibuzzard-6732257B: G***; kibuzzard-6732257B
kibuzzard-6732261A: G***; kibuzzard-6732261A
kibuzzard-6732266F: G***; kibuzzard-6732266F
kibuzzard-6732270D: G***; kibuzzard-6732270D
kibuzzard-6732274F: G***; kibuzzard-6732274F
kibuzzard-6732277B: G***; kibuzzard-6732277B
kibuzzard-6732278E: G***; kibuzzard-6732278E
kibuzzard-6732279D: G***; kibuzzard-6732279D
kibuzzard-67322575: G***; kibuzzard-67322575
kibuzzard-67322649, kibuzzard-67322649#2, kibuzzard-67322649#3, kibuzzard-67322649#4, kibuzzard-67322649#5, kibuzzard-67322649#6, kibuzzard-67322649#7, kibuzzard-67322649#8: G***; kibuzzard-67322649
kibuzzard-67322650, kibuzzard-67322650#2, kibuzzard-67322650#3, kibuzzard-67322650#4: G***; kibuzzard-67322650
kibuzzard-67322655: G***; kibuzzard-67322655
kibuzzard-67322681: G***; kibuzzard-67322681
kibuzzard-67322686: G***; kibuzzard-67322686
kibuzzard-67322714: G***; kibuzzard-67322714
kibuzzard-67322749: G***; kibuzzard-67322749
kibuzzard-67322755: G***; kibuzzard-67322755
kibuzzard-67322768: G***; kibuzzard-67322768
kibuzzard-67322783: G***; kibuzzard-67322783
kibuzzard-67322796: G***; kibuzzard-67322796
kibuzzard-67322833: G***; kibuzzard-67322833

Their connections:
GND: H1#2.1; also elsewhere on the board
