mikld86/GMTiredandForked/src/display/plugins/BLEScalePlugin.cpp

#include "BLEScalePlugin.h"
#include "remote_scales.h"
#include "remote_scales_plugin_registry.h"
#include <display/core/Controller.h>
#include <scales/acaia.h>
#include <scales/bookoo.h>
#include <scales/decent.h>
#include <scales/difluid.h>
#include <scales/eclair.h>
#include <scales/eureka.h>
#include <scales/felicitaScale.h>
#include <scales/myscale.h>
#include <scales/timemore.h>
#include <scales/varia.h>
#include <scales/weighmybru.h>

void on_ble_measurement(float value) { BLEScales.onMeasurement(value); }

BLEScalePlugin BLEScales;

BLEScalePlugin::BLEScalePlugin() = default;

void BLEScalePlugin::setup(Controller *controller, PluginManager *manager) {
    this->controller = controller;
    this->pluginRegistry = RemoteScalesPluginRegistry::getInstance();
    AcaiaScalesPlugin::apply();
    BookooScalesPlugin::apply();
    DecentScalesPlugin::apply();
    DifluidScalesPlugin::apply();
    EclairScalesPlugin::apply();
    EurekaScalesPlugin::apply();
    FelicitaScalePlugin::apply();
    TimemoreScalesPlugin::apply();
    VariaScalesPlugin::apply();
    WeighMyBrewScalePlugin::apply();
    myscalePlugin::apply();
    this->scanner = new RemoteScalesScanner();
    manager->on("controller:ready", [this](Event const &) {
        if (this->controller->getMode() != MODE_STANDBY) {
            ESP_LOGI("BLEScalePlugin", "Resuming scanning");
            scan();
            active = true;
        }
    });
    manager->on("controller:brew:prestart", [this](Event const &) { onProcessStart(); });
    manager->on("controller:grind:start", [this](Event const &) { onProcessStart(); });
    manager->on("controller:mode:change", [this](Event const &event) {
        if (event.getInt("value") != MODE_STANDBY) {
            ESP_LOGI("BLEScalePlugin", "Resuming scanning");
            scan();
            active = true;
        } else {
            active = false;
            disconnect();
            scanner->stopAsyncScan();
            ESP_LOGI("BLEScalePlugin", "Stopping scanning, disconnecting");
        }
    });
}

void BLEScalePlugin::loop() {
    if (doConnect && scale == nullptr) {
        establishConnection();
    }
    const unsigned long now = millis();
    if (now - lastUpdate > UPDATE_INTERVAL_MS) {
        lastUpdate = now;
        update();
    }
}

void BLEScalePlugin::update() {
    controller->setVolumetricOverride(scale != nullptr && scale->isConnected());
    if (!active)
        return;
    if (scale != nullptr) {
        scale->update();
        if (!scale->isConnected()) {
            reconnectionTries++;
            if (reconnectionTries > RECONNECTION_TRIES) {
                disconnect();
                this->scanner->initializeAsyncScan();
            }
        }
    } else if (controller->getSettings().getSavedScale() != "") {
        for (const auto &d : scanner->getDiscoveredScales()) {
            if (d.getAddress().toString() == controller->getSettings().getSavedScale().c_str()) {
                ESP_LOGI("BLEScalePlugin", "Connecting to last known scale");
                connect(d.getAddress().toString());
            }
        }
    }
}

void BLEScalePlugin::connect(const std::string &uuid) {
    doConnect = true;
    this->uuid = uuid;
    controller->getSettings().setSavedScale(uuid.data());
}

void BLEScalePlugin::scan() const {
    if (scale != nullptr && scale->isConnected()) {
        return;
    }
    scanner->initializeAsyncScan();
}

void BLEScalePlugin::disconnect() {
    if (scale != nullptr) {
        scale->disconnect();
        scale = nullptr;
        uuid = "";
        doConnect = false;
    }
}

void BLEScalePlugin::onProcessStart() const {
    if (scale != nullptr && scale->isConnected()) {
        scale->tare();
        delay(50);
        scale->tare();
    }
}

void BLEScalePlugin::establishConnection() {
    ESP_LOGI("BLEScalePlugin", "Connecting to %s", uuid.c_str());
    scanner->stopAsyncScan();
    for (const auto &d : scanner->getDiscoveredScales()) {
        if (d.getAddress().toString() == uuid) {
            reconnectionTries = 0;
            scale = RemoteScalesFactory::getInstance()->create(d);
            if (!scale) {
                ESP_LOGE("BLEScalePlugin", "Connection to device %s failed\n", d.getName().c_str());
                return;
            }

            scale->setLogCallback([](std::string message) { Serial.print(message.c_str()); });

            scale->setWeightUpdatedCallback([](float weight) { BLEScales.onMeasurement(weight); });

            if (!scale->connect()) {
                disconnect();
                this->scanner->initializeAsyncScan();
            }
            break;
        }
    }
}

void BLEScalePlugin::onMeasurement(float value) const {
    if (controller != nullptr) {
        controller->onVolumetricMeasurement(value, VolumetricMeasurementSource::BLUETOOTH);
    }
}

std::vector<DiscoveredDevice> BLEScalePlugin::getDiscoveredScales() const { return scanner->getDiscoveredScales(); }
