mikld86/GMTiredandForked/src/display/plugins/mDNSPlugin.cpp

#include "mDNSPlugin.h"
#include "../core/Controller.h"
#include "../core/Event.h"
#include <ESPmDNS.h>
#include <WiFi.h>

void mDNSPlugin::setup(Controller *controller, PluginManager *pluginManager) {
    this->controller = controller;
    pluginManager->on("controller:wifi:connect", [this](Event const &event) { start(event); });
}
void mDNSPlugin::start(Event const &event) const {
    const int apMode = event.getInt("AP");
    if (apMode)
        return;
    if (!MDNS.begin(controller->getSettings().getMdnsName().c_str())) {
        Serial.println(F("Error setting up MDNS responder!"));
    }
}
