mikld86/GMTiredandForked/src/display/plugins/BLEScalePlugin.h

#ifndef BLESCALEPLUGIN_H
#define BLESCALEPLUGIN_H
#include "../core/Plugin.h"
#include "remote_scales.h"
#include "remote_scales_plugin_registry.h"

void on_ble_measurement(float value);

constexpr unsigned long UPDATE_INTERVAL_MS = 1000;
constexpr unsigned int RECONNECTION_TRIES = 15;

class BLEScalePlugin : public Plugin {
  public:
    BLEScalePlugin();

    void setup(Controller *controller, PluginManager *pluginManager) override;
    void loop() override;
    ;

    void connect(const std::string &uuid);
    void scan() const;
    void disconnect();
    void onMeasurement(float value) const;
    bool isConnected() { return scale != nullptr && scale->isConnected(); };
    std::string getName() { return isConnected() ? scale->getDeviceName() : ""; };
    std::string getUUID() { return isConnected() ? scale->getDeviceAddress() : ""; };

    std::vector<DiscoveredDevice> getDiscoveredScales() const;

  private:
    void update();
    void onProcessStart() const;

    void establishConnection();

    bool active = false;
    bool doConnect = false;
    std::string uuid;

    unsigned long lastUpdate = 0;
    unsigned int reconnectionTries = 0;

    Controller *controller = nullptr;
    RemoteScalesPluginRegistry *pluginRegistry = nullptr;
    RemoteScalesScanner *scanner = nullptr;
    std::unique_ptr<RemoteScales> scale = nullptr;
};

extern BLEScalePlugin BLEScales;

#endif // BLESCALEPLUGIN_H
