mikld86/GMTiredandForked/src/display/plugins/SmartGrindPlugin.h

#ifndef SMARTGRINDPLUGIN_H
#define SMARTGRINDPLUGIN_H
#include "../core/Plugin.h"
#include <Arduino.h>

const String COMMAND_ON = "Power%20On";
const String COMMAND_OFF = "Power%20off";

constexpr int SG_MODE_OFF = 0;
constexpr int SG_MODE_OFF_ON = 1;
constexpr int SG_MODE_ON_OFF = 2;

struct Event;

class SmartGrindPlugin : public Plugin {
  public:
    void setup(Controller *controller, PluginManager *pluginManager) override;
    void loop() override {};

  private:
    void start();
    void stop();
    void controlRelay(String command);

    Controller *controller = nullptr;
};

#endif // SMARTGRINDPLUGIN_H
