mikld86/GMTiredandForked/src/display/core/PluginManager.h

#ifndef PLUGINMANAGER_H
#define PLUGINMANAGER_H
#include "Event.h"
#include "Plugin.h"

#include <functional>
#include <map>
#include <string>
#include <vector>

using EventCallback = std::function<void(Event &)>;

class Controller;
class PluginManager {
  public:
    void registerPlugin(Plugin *plugin);

    void setup(Controller *controller);
    void loop();

    void on(const String &eventId, const EventCallback &callback);

    Event trigger(const String &eventId);
    Event trigger(const String &eventId, const String &key, const String &value);
    Event trigger(const String &eventId, const String &key, int value);
    Event trigger(const String &eventId, const String &key, float value);
    void trigger(Event &event);

  private:
    bool initialized = false;
    std::vector<Plugin *> plugins;
    std::map<std::string, std::vector<EventCallback>> listeners = {};
};

#endif // PLUGINMANAGER_H
