mikld86/GMTiredandForked/src/display/plugins/mDNSPlugin.h

#ifndef MDNSPLUGIN_H
#define MDNSPLUGIN_H
#include "../core/Plugin.h"

struct Event;

class mDNSPlugin : public Plugin {
  public:
    void setup(Controller *controller, PluginManager *pluginManager) override;
    void loop() override {};

  private:
    void start(Event const &event) const;

    Controller *controller = nullptr;
};

#endif // MDNSPLUGIN_H
