mikld86/GMTiredandForked/src/display/ui/default/DefaultUI.cpp

#include "DefaultUI.h"

#include <WiFi.h>
#include <display/config.h>
#include <display/core/Controller.h>
#include <display/core/process/BrewProcess.h>
#include <display/core/process/Process.h>
#include <display/core/zones.h>
#include <display/drivers/LilyGoDriver.h>
#include <display/drivers/LilyGoTDisplayDriver.h>
#include <display/drivers/WaveshareDriver.h>
#include <display/drivers/common/LV_Helper.h>
#include <display/ui/default/lvgl/ui_theme_manager.h>
#include <display/ui/default/lvgl/ui_themes.h>
#include <display/ui/utils/effects.h>

#include "esp_sntp.h"

static EffectManager effect_mgr;

int16_t calculate_angle(int set_temp, int range, int offset) {
    const double percentage = static_cast<double>(set_temp) / static_cast<double>(MAX_TEMP);
    return (percentage * ((double)range)) - range / 2 - offset;
}

void DefaultUI::updateTempHistory() {
    if (currentTemp > 0) {
        tempHistory[tempHistoryIndex] = currentTemp;
        tempHistoryIndex += 1;
    }

    if (tempHistoryIndex > TEMP_HISTORY_LENGTH) {
        tempHistoryIndex = 0;
        isTempHistoryInitialized = true;
    }

    if (tempHistoryIndex % 4 == 0) {
        heatingFlash = !heatingFlash;
        rerender = true;
    }
}

void DefaultUI::updateTempStableFlag() {
    if (isTempHistoryInitialized) {
        float totalError = 0.0f;
        float maxError = 0.0f;
        for (uint16_t i = 0; i < TEMP_HISTORY_LENGTH; i++) {
            float error = abs(tempHistory[i] - targetTemp);
            totalError += error;
            maxError = error > maxError ? error : maxError;
        }

        const float avgError = totalError / TEMP_HISTORY_LENGTH;
        const float errorMargin = max(2.0f, static_cast<float>(targetTemp) * 0.02f);

        isTemperatureStable = avgError < errorMargin && maxError <= errorMargin;
    }

    // instantly reset stability if setpoint has changed
    if (prevTargetTemp != targetTemp) {
        isTemperatureStable = false;
    }

    prevTargetTemp = targetTemp;
}

void DefaultUI::adjustHeatingIndicator(lv_obj_t *dials) {
    lv_obj_t *heatingIcon = ui_comp_get_child(dials, UI_COMP_DIALS_TEMPICON);
    lv_obj_set_style_img_recolor(heatingIcon, lv_color_hex(isTemperatureStable ? 0x00D100 : 0xF62C2C),
                                 LV_PART_MAIN | LV_STATE_DEFAULT);
    if (!isTemperatureStable) {
        lv_obj_set_style_opa(heatingIcon, heatingFlash ? LV_OPA_50 : LV_OPA_100, LV_PART_MAIN | LV_STATE_DEFAULT);
    }
}

DefaultUI::DefaultUI(Controller *controller, PluginManager *pluginManager)
    : controller(controller), pluginManager(pluginManager) {
    profileManager = controller->getProfileManager();
}

void DefaultUI::init() {
    auto triggerRender = [this](Event const &) { rerender = true; };
    pluginManager->on("boiler:currentTemperature:change", [=](Event const &event) {
        int newTemp = static_cast<int>(event.getFloat("value"));
        if (newTemp != currentTemp) {
            currentTemp = newTemp;
            rerender = true;
        }
    });
    pluginManager->on("boiler:pressure:change", [=](Event const &event) {
        float newPressure = event.getFloat("value");
        if (round(newPressure * 10.0f) != round(pressure * 10.0f)) {
            pressure = newPressure;
            rerender = true;
        }
    });
    pluginManager->on("boiler:targetTemperature:change", [=](Event const &event) {
        int newTemp = static_cast<int>(event.getFloat("value"));
        if (newTemp != targetTemp) {
            targetTemp = newTemp;
            rerender = true;
        }
    });
    pluginManager->on("controller:grindDuration:change", [=](Event const &event) {
        grindDuration = event.getInt("value");
        rerender = true;
    });
    pluginManager->on("controller:grindVolume:change", [=](Event const &event) {
        grindVolume = event.getFloat("value");
        rerender = true;
    });
    pluginManager->on("controller:process:end", triggerRender);
    pluginManager->on("controller:process:start", triggerRender);
    pluginManager->on("controller:mode:change", [this](Event const &event) {
        mode = event.getInt("value");
        switch (mode) {
        case MODE_STANDBY:
            changeScreen(&ui_StandbyScreen, &ui_StandbyScreen_screen_init);
            break;
        case MODE_BREW:
            changeScreen(&ui_BrewScreen, &ui_BrewScreen_screen_init);
            break;
        case MODE_GRIND:
            changeScreen(&ui_GrindScreen, &ui_GrindScreen_screen_init);
            break;
        case MODE_STEAM:
            changeScreen(&ui_SimpleProcessScreen, &ui_SimpleProcessScreen_screen_init);
            break;
        case MODE_WATER:
            changeScreen(&ui_SimpleProcessScreen, &ui_SimpleProcessScreen_screen_init);
            break;
        default:
            break;
        };
    });
    pluginManager->on("controller:brew:start",
                      [this](Event const &event) { changeScreen(&ui_StatusScreen, &ui_StatusScreen_screen_init); });
    pluginManager->on("controller:brew:clear", [this](Event const &event) {
        if (lv_scr_act() == ui_StatusScreen) {
            changeScreen(&ui_BrewScreen, &ui_BrewScreen_screen_init);
        }
    });
    pluginManager->on("controller:bluetooth:connect", [this](Event const &) {
        rerender = true;
        if (lv_scr_act() == ui_InitScreen) {
            Settings &settings = controller->getSettings();
            settings.getStartupMode() == MODE_BREW ? changeScreen(&ui_BrewScreen, &ui_BrewScreen_screen_init)
                                                   : changeScreen(&ui_StandbyScreen, &ui_StandbyScreen_screen_init);
        }
        pressureAvailable = controller->getSystemInfo().capabilities.pressure;
    });
    pluginManager->on("controller:wifi:connect", [this](Event const &event) {
        configTzTime(resolve_timezone(controller->getSettings().getTimezone()), NTP_SERVER);
        setenv("TZ", resolve_timezone(controller->getSettings().getTimezone()), 1);
        tzset();
        sntp_set_sync_mode(SNTP_SYNC_MODE_SMOOTH);
        sntp_setservername(0, NTP_SERVER);
        sntp_init();
        rerender = true;
        apActive = event.getInt("AP");
    });
    pluginManager->on("ota:update:start", [this](Event const &) {
        updateActive = true;
        rerender = true;
        changeScreen(&ui_InitScreen, &ui_InitScreen_screen_init);
    });
    pluginManager->on("ota:update:end", [this](Event const &) {
        updateActive = false;
        rerender = true;
        changeScreen(&ui_InitScreen, &ui_InitScreen_screen_init);
    });
    pluginManager->on("ota:update:status", [this](Event const &event) {
        rerender = true;
        updateAvailable = event.getInt("value");
    });
    pluginManager->on("controller:error", [this](Event const &) {
        rerender = true;
        changeScreen(&ui_InitScreen, &ui_InitScreen_screen_init);
    });
    pluginManager->on("controller:autotune:start",
                      [this](Event const &) { changeScreen(&ui_InitScreen, &ui_InitScreen_screen_init); });
    pluginManager->on("controller:autotune:result",
                      [this](Event const &) { changeScreen(&ui_StandbyScreen, &ui_StandbyScreen_screen_init); });

    pluginManager->on("profiles:profile:select", [this](Event const &event) {
        selectedProfileId = event.getString("id");
        profileManager->loadSelectedProfile(selectedProfile);
    });
    setupPanel();
    setupState();
    setupReactive();
    xTaskCreatePinnedToCore(loopTask, "DefaultUI::loop", configMINIMAL_STACK_SIZE * 6, this, 1, &taskHandle, 1);
    xTaskCreatePinnedToCore(profileLoopTask, "DefaultUI::loopProfiles", configMINIMAL_STACK_SIZE * 4, this, 1, &profileTaskHandle,
                            0);
}

void DefaultUI::loop() {
    const unsigned long now = millis();
    const unsigned long diff = now - lastRender;

    if (now - lastTempLog > TEMP_HISTORY_INTERVAL) {
        updateTempHistory();
        lastTempLog = now;
    }

    if ((controller->isActive() && diff > RERENDER_INTERVAL_ACTIVE) || diff > RERENDER_INTERVAL_IDLE) {
        rerender = true;
    }

    if (rerender) {
        rerender = false;
        lastRender = now;
        error = controller->isErrorState();
        autotuning = controller->isAutotuning();
        const Settings &settings = controller->getSettings();
        volumetricAvailable = controller->isVolumetricAvailable();
        volumetricMode = volumetricAvailable && settings.isVolumetricTarget();
        grindActive = controller->isGrindActive();
        active = controller->isActive();
        applyTheme();
        if (controller->isErrorState()) {
            changeScreen(&ui_InitScreen, &ui_InitScreen_screen_init);
        }
        updateTempStableFlag();
        handleScreenChange();
        currentScreen = lv_scr_act();
        if (lv_scr_act() == ui_StandbyScreen)
            updateStandbyScreen();
        if (lv_scr_act() == ui_StatusScreen)
            updateStatusScreen();
        effect_mgr.evaluate_all();
    }

    lv_task_handler();
}

void DefaultUI::loopProfiles() {
    if (!profileLoaded && currentProfileId != "") {
        profileManager->loadProfile(currentProfileId, currentProfileChoice);
        profileLoaded = 1;
    }
}

void DefaultUI::changeScreen(lv_obj_t **screen, void (*target_init)()) {
    targetScreen = screen;
    targetScreenInit = target_init;
    rerender = true;
}

void DefaultUI::onProfileSwitch() {
    favoritedProfiles = profileManager->getFavoritedProfiles();
    currentProfileIdx = 0;
    currentProfileId = favoritedProfiles[currentProfileIdx];
    profileLoaded = 0;
    currentProfileChoice = Profile{};
    changeScreen(&ui_ProfileScreen, ui_ProfileScreen_screen_init);
}

void DefaultUI::onNextProfile() {
    if (currentProfileIdx < favoritedProfiles.size() - 1) {
        currentProfileIdx++;
        currentProfileId = favoritedProfiles.at(currentProfileIdx);
        profileLoaded = 0;
        currentProfileChoice = Profile{};
    }
}

void DefaultUI::onPreviousProfile() {
    if (currentProfileIdx > 0) {
        currentProfileIdx--;
        currentProfileId = favoritedProfiles.at(currentProfileIdx);
        profileLoaded = 0;
        currentProfileChoice = Profile{};
    }
}

void DefaultUI::onProfileSelect() {
    profileManager->selectProfile(currentProfileId);
    changeScreen(&ui_BrewScreen, ui_BrewScreen_screen_init);
}

void DefaultUI::setupPanel() {
    if (LilyGoTDisplayDriver::getInstance()->isCompatible()) {
        panelDriver = LilyGoTDisplayDriver::getInstance();
    } else if (LilyGoDriver::getInstance()->isCompatible()) {
        panelDriver = LilyGoDriver::getInstance();
    } else if (WaveshareDriver::getInstance()->isCompatible()) {
        panelDriver = WaveshareDriver::getInstance();
    } else {
        Serial.println("No compatible display driver found");
        delay(10000);
        ESP.restart();
    }
    panelDriver->init();
    ui_init();

    // Set initial brightness based on settings
    const Settings &settings = controller->getSettings();
    setBrightness(settings.getMainBrightness());
}

void DefaultUI::setupState() {
    error = controller->isErrorState();
    autotuning = controller->isAutotuning();
    const Settings &settings = controller->getSettings();
    volumetricAvailable = controller->isVolumetricAvailable();
    volumetricMode = volumetricAvailable && settings.isVolumetricTarget();
    grindActive = controller->isGrindActive();
    active = controller->isActive();
    mode = controller->getMode();
    currentTemp = static_cast<int>(controller->getCurrentTemp());
    targetTemp = static_cast<int>(controller->getTargetTemp());
    targetDuration = controller->getTargetDuration();
    targetVolume = settings.getTargetVolume();
    grindDuration = settings.getTargetGrindDuration();
    grindVolume = settings.getTargetGrindVolume();
    pressureAvailable = controller->getSystemInfo().capabilities.pressure ? 1 : 0;
    pressureScaling = std::ceil(settings.getPressureScaling());
    selectedProfileId = settings.getSelectedProfile();
    profileManager->loadSelectedProfile(selectedProfile);
}

void DefaultUI::setupReactive() {
    effect_mgr.use_effect([=] { return currentScreen == ui_MenuScreen; }, [=]() { adjustDials(ui_MenuScreen_dials); },
                          &pressureAvailable);
    effect_mgr.use_effect([=] { return currentScreen == ui_StatusScreen; }, [=]() { adjustDials(ui_StatusScreen_dials); },
                          &pressureAvailable);
    effect_mgr.use_effect([=] { return currentScreen == ui_BrewScreen; }, [=]() { adjustDials(ui_BrewScreen_dials); },
                          &pressureAvailable);
    effect_mgr.use_effect([=] { return currentScreen == ui_GrindScreen; }, [=]() { adjustDials(ui_GrindScreen_dials); },
                          &pressureAvailable);
    effect_mgr.use_effect([=] { return currentScreen == ui_SimpleProcessScreen; },
                          [=]() { adjustDials(ui_SimpleProcessScreen_dials); }, &pressureAvailable);
    effect_mgr.use_effect([=] { return currentScreen == ui_ProfileScreen; }, [=]() { adjustDials(ui_ProfileScreen_dials); },
                          &pressureAvailable);
    effect_mgr.use_effect([=] { return currentScreen == ui_BrewScreen; }, [=]() { adjustHeatingIndicator(ui_BrewScreen_dials); },
                          &isTemperatureStable, &heatingFlash);
    effect_mgr.use_effect([=] { return currentScreen == ui_SimpleProcessScreen; },
                          [=]() { adjustHeatingIndicator(ui_SimpleProcessScreen_dials); }, &isTemperatureStable, &heatingFlash);
    effect_mgr.use_effect([=] { return currentScreen == ui_MenuScreen; }, [=]() { adjustHeatingIndicator(ui_MenuScreen_dials); },
                          &isTemperatureStable, &heatingFlash);
    effect_mgr.use_effect([=] { return currentScreen == ui_ProfileScreen; },
                          [=]() { adjustHeatingIndicator(ui_ProfileScreen_dials); }, &isTemperatureStable, &heatingFlash);
    effect_mgr.use_effect([=] { return currentScreen == ui_GrindScreen; },
                          [=]() { adjustHeatingIndicator(ui_GrindScreen_dials); }, &isTemperatureStable, &heatingFlash);
    effect_mgr.use_effect([=] { return currentScreen == ui_StatusScreen; },
                          [=]() { adjustHeatingIndicator(ui_StatusScreen_dials); }, &isTemperatureStable, &heatingFlash);
    effect_mgr.use_effect([=] { return currentScreen == ui_SimpleProcessScreen; },
                          [=]() { lv_label_set_text(ui_SimpleProcessScreen_mainLabel5, mode == MODE_STEAM ? "Steam" : "Water"); },
                          &mode);
    effect_mgr.use_effect([=] { return currentScreen == ui_MenuScreen; },
                          [=]() {
                              lv_arc_set_value(uic_MenuScreen_dials_tempGauge, currentTemp);
                              lv_label_set_text_fmt(uic_MenuScreen_dials_tempText, "%d°C", currentTemp);
                          },
                          &currentTemp);
    effect_mgr.use_effect([=] { return currentScreen == ui_StatusScreen; },
                          [=]() {
                              lv_arc_set_value(uic_StatusScreen_dials_tempGauge, currentTemp);
                              lv_label_set_text_fmt(uic_StatusScreen_dials_tempText, "%d°C", currentTemp);
                          },
                          &currentTemp);
    effect_mgr.use_effect([=] { return currentScreen == ui_BrewScreen; },
                          [=]() {
                              lv_arc_set_value(uic_BrewScreen_dials_tempGauge, currentTemp);
                              lv_label_set_text_fmt(uic_BrewScreen_dials_tempText, "%d°C", currentTemp);
                          },
                          &currentTemp);
    effect_mgr.use_effect([=] { return currentScreen == ui_GrindScreen; },
                          [=]() {
                              lv_arc_set_value(uic_GrindScreen_dials_tempGauge, currentTemp);
                              lv_label_set_text_fmt(uic_GrindScreen_dials_tempText, "%d°C", currentTemp);
                          },
                          &currentTemp);
    effect_mgr.use_effect([=] { return currentScreen == ui_SimpleProcessScreen; },
                          [=]() {
                              lv_arc_set_value(uic_SimpleProcessScreen_dials_tempGauge, currentTemp);
                              lv_label_set_text_fmt(uic_SimpleProcessScreen_dials_tempText, "%d°C", currentTemp);
                          },
                          &currentTemp);
    effect_mgr.use_effect([=] { return currentScreen == ui_ProfileScreen; },
                          [=]() {
                              lv_arc_set_value(uic_ProfileScreen_dials_tempGauge, currentTemp);
                              lv_label_set_text_fmt(uic_ProfileScreen_dials_tempText, "%d°C", currentTemp);
                          },
                          &currentTemp);
    effect_mgr.use_effect([=] { return currentScreen == ui_MenuScreen; }, [=]() { adjustTempTarget(ui_MenuScreen_dials); },
                          &targetTemp);
    effect_mgr.use_effect([=] { return currentScreen == ui_StatusScreen; },
                          [=]() {
                              lv_label_set_text_fmt(ui_StatusScreen_targetTemp, "%d°C", targetTemp);
                              adjustTempTarget(ui_StatusScreen_dials);
                          },
                          &targetTemp);
    effect_mgr.use_effect([=] { return currentScreen == ui_BrewScreen; },
                          [=]() {
                              lv_label_set_text_fmt(ui_BrewScreen_targetTemp, "%d°C", targetTemp);
                              adjustTempTarget(ui_BrewScreen_dials);
                          },
                          &targetTemp);
    effect_mgr.use_effect([=] { return currentScreen == ui_GrindScreen; }, [=]() { adjustTempTarget(ui_GrindScreen_dials); },
                          &targetTemp);
    effect_mgr.use_effect([=] { return currentScreen == ui_SimpleProcessScreen; },
                          [=]() {
                              lv_label_set_text_fmt(ui_SimpleProcessScreen_targetTemp, "%d°C", targetTemp);
                              adjustTempTarget(ui_SimpleProcessScreen_dials);
                          },
                          &targetTemp);
    effect_mgr.use_effect([=] { return currentScreen == ui_ProfileScreen; }, [=]() { adjustTempTarget(ui_ProfileScreen_dials); },
                          &targetTemp);
    effect_mgr.use_effect([=] { return currentScreen == ui_MenuScreen; },
                          [=]() {
                              lv_arc_set_value(uic_MenuScreen_dials_pressureGauge, pressure * 10.0f);
                              lv_label_set_text_fmt(uic_MenuScreen_dials_pressureText, "%.1f bar", pressure);
                          },
                          &pressure);
    effect_mgr.use_effect([=] { return currentScreen == ui_StatusScreen; },
                          [=]() {
                              lv_arc_set_value(uic_StatusScreen_dials_pressureGauge, pressure * 10.0f);
                              lv_label_set_text_fmt(uic_StatusScreen_dials_pressureText, "%.1f bar", pressure);
                          },
                          &pressure);
    effect_mgr.use_effect([=] { return currentScreen == ui_BrewScreen; },
                          [=]() {
                              lv_arc_set_value(uic_BrewScreen_dials_pressureGauge, pressure * 10.0f);
                              lv_label_set_text_fmt(uic_BrewScreen_dials_pressureText, "%.1f bar", pressure);
                          },
                          &pressure);
    effect_mgr.use_effect([=] { return currentScreen == ui_GrindScreen; },
                          [=]() {
                              lv_arc_set_value(uic_GrindScreen_dials_pressureGauge, pressure * 10.0f);
                              lv_label_set_text_fmt(uic_GrindScreen_dials_pressureText, "%.1f bar", pressure);
                          },
                          &pressure);
    effect_mgr.use_effect([=] { return currentScreen == ui_SimpleProcessScreen; },
                          [=]() {
                              lv_arc_set_value(uic_SimpleProcessScreen_dials_pressureGauge, pressure * 10.0f);
                              lv_label_set_text_fmt(uic_SimpleProcessScreen_dials_pressureText, "%.1f bar", pressure);
                          },
                          &pressure);
    effect_mgr.use_effect([=] { return currentScreen == ui_ProfileScreen; },
                          [=]() {
                              lv_arc_set_value(uic_ProfileScreen_dials_pressureGauge, pressure * 10.0f);
                              lv_label_set_text_fmt(uic_ProfileScreen_dials_pressureText, "%.1f bar", pressure);
                          },
                          &pressure);
    effect_mgr.use_effect([=] { return currentScreen == ui_StandbyScreen; },
                          [=]() {
                              updateAvailable ? lv_obj_clear_flag(ui_StandbyScreen_updateIcon, LV_OBJ_FLAG_HIDDEN)
                                              : lv_obj_add_flag(ui_StandbyScreen_updateIcon, LV_OBJ_FLAG_HIDDEN);
                          },
                          &updateAvailable);
    effect_mgr.use_effect([=] { return currentScreen == ui_InitScreen; },
                          [=]() {
                              if (updateActive) {
                                  lv_label_set_text_fmt(ui_InitScreen_mainLabel, "Updating...");
                              } else if (error) {
                                  if (controller->getError() == ERROR_CODE_RUNAWAY) {
                                      lv_label_set_text_fmt(ui_InitScreen_mainLabel, "Temperature error, please restart");
                                  }
                              } else if (autotuning) {
                                  lv_label_set_text_fmt(ui_InitScreen_mainLabel, "Autotuning...");
                              }
                          },
                          &updateAvailable, &error, &autotuning);
    effect_mgr.use_effect([=] { return currentScreen == ui_BrewScreen; },
                          [=]() {
                              if (volumetricMode) {
                                  lv_label_set_text_fmt(ui_BrewScreen_targetDuration, "%dg", targetVolume);
                              } else {
                                  const double secondsDouble = targetDuration / 1000.0;
                                  const auto minutes = static_cast<int>(secondsDouble / 60.0 - 0.5);
                                  const auto seconds = static_cast<int>(secondsDouble) % 60;
                                  lv_label_set_text_fmt(ui_BrewScreen_targetDuration, "%2d:%02d", minutes, seconds);
                              }
                          },
                          &targetDuration, &targetVolume, &volumetricMode);
    effect_mgr.use_effect([=] { return currentScreen == ui_GrindScreen; },
                          [=]() {
                              if (volumetricMode) {
                                  lv_label_set_text_fmt(ui_GrindScreen_targetDuration, "%.1fg", grindVolume);
                              } else {
                                  const double secondsDouble = grindDuration / 1000.0;
                                  const auto minutes = static_cast<int>(secondsDouble / 60.0 - 0.5);
                                  const auto seconds = static_cast<int>(secondsDouble) % 60;
                                  lv_label_set_text_fmt(ui_GrindScreen_targetDuration, "%2d:%02d", minutes, seconds);
                              }
                          },
                          &grindDuration, &grindVolume, &volumetricMode);
    effect_mgr.use_effect(
        [=] { return currentScreen == ui_BrewScreen; },
        [=]() {
            lv_img_set_src(ui_BrewScreen_Image4, volumetricMode ? &ui_img_1424216268 : &ui_img_360122106);
            ui_object_set_themeable_style_property(ui_BrewScreen_timedButton, LV_PART_MAIN | LV_STATE_DEFAULT,
                                                   LV_STYLE_BG_IMG_RECOLOR,
                                                   volumetricMode ? _ui_theme_color_NiceWhite : _ui_theme_color_Dark);
            ui_object_set_themeable_style_property(ui_BrewScreen_volumetricButton, LV_PART_MAIN | LV_STATE_DEFAULT,
                                                   LV_STYLE_BG_IMG_RECOLOR,
                                                   volumetricMode ? _ui_theme_color_Dark : _ui_theme_color_NiceWhite);
            ui_object_set_themeable_style_property(ui_BrewScreen_modeSwitch, LV_PART_MAIN | LV_STATE_DEFAULT, LV_STYLE_BG_COLOR,
                                                   volumetricMode ? _ui_theme_color_Dark : _ui_theme_color_NiceWhite);
            ui_object_set_themeable_style_property(ui_BrewScreen_modeSwitch, LV_PART_MAIN | LV_STATE_DEFAULT,
                                                   LV_STYLE_BG_GRAD_COLOR,
                                                   volumetricMode ? _ui_theme_color_NiceWhite : _ui_theme_color_Dark);
        },
        &volumetricMode);
    effect_mgr.use_effect(
        [=] { return currentScreen == ui_GrindScreen; },
        [=]() {
            lv_img_set_src(ui_GrindScreen_targetSymbol, volumetricMode ? &ui_img_1424216268 : &ui_img_360122106);
            ui_object_set_themeable_style_property(ui_GrindScreen_timedButton, LV_PART_MAIN | LV_STATE_DEFAULT,
                                                   LV_STYLE_BG_IMG_RECOLOR,
                                                   volumetricMode ? _ui_theme_color_NiceWhite : _ui_theme_color_Dark);
            ui_object_set_themeable_style_property(ui_GrindScreen_volumetricButton, LV_PART_MAIN | LV_STATE_DEFAULT,
                                                   LV_STYLE_BG_IMG_RECOLOR,
                                                   volumetricMode ? _ui_theme_color_Dark : _ui_theme_color_NiceWhite);
            ui_object_set_themeable_style_property(ui_GrindScreen_modeSwitch, LV_PART_MAIN | LV_STATE_DEFAULT, LV_STYLE_BG_COLOR,
                                                   volumetricMode ? _ui_theme_color_Dark : _ui_theme_color_NiceWhite);
            ui_object_set_themeable_style_property(ui_GrindScreen_modeSwitch, LV_PART_MAIN | LV_STATE_DEFAULT,
                                                   LV_STYLE_BG_GRAD_COLOR,
                                                   volumetricMode ? _ui_theme_color_NiceWhite : _ui_theme_color_Dark);
        },
        &volumetricMode);
    effect_mgr.use_effect([=] { return currentScreen == ui_BrewScreen; },
                          [=]() {
                              if (volumetricAvailable) {
                                  lv_obj_clear_flag(ui_BrewScreen_modeSwitch, LV_OBJ_FLAG_HIDDEN);
                              } else {
                                  lv_obj_add_flag(ui_BrewScreen_modeSwitch, LV_OBJ_FLAG_HIDDEN);
                              }
                          },
                          &volumetricAvailable);
    effect_mgr.use_effect([=] { return currentScreen == ui_GrindScreen; },
                          [=]() {
                              if (volumetricAvailable) {
                                  lv_obj_clear_flag(ui_GrindScreen_modeSwitch, LV_OBJ_FLAG_HIDDEN);
                              } else {
                                  lv_obj_add_flag(ui_GrindScreen_modeSwitch, LV_OBJ_FLAG_HIDDEN);
                              }
                          },
                          &volumetricAvailable);
    effect_mgr.use_effect([=] { return currentScreen == ui_SimpleProcessScreen; },
                          [=]() {
                              if (mode == MODE_STEAM) {
                                  _ui_flag_modify(ui_SimpleProcessScreen_goButton, LV_OBJ_FLAG_HIDDEN, active);
                                  lv_imgbtn_set_src(ui_SimpleProcessScreen_goButton, LV_IMGBTN_STATE_RELEASED, nullptr,
                                                    &ui_img_691326438, nullptr);
                              } else {
                                  lv_imgbtn_set_src(ui_SimpleProcessScreen_goButton, LV_IMGBTN_STATE_RELEASED, nullptr,
                                                    active ? &ui_img_1456692430 : &ui_img_445946954, nullptr);
                              }
                          },
                          &active, &mode);
    effect_mgr.use_effect([=] { return currentScreen == ui_GrindScreen; },
                          [=]() {
                              lv_imgbtn_set_src(ui_GrindScreen_startButton, LV_IMGBTN_STATE_RELEASED, nullptr,
                                                grindActive ? &ui_img_1456692430 : &ui_img_445946954, nullptr);
                          },
                          &grindActive);
    effect_mgr.use_effect([=] { return currentScreen == ui_BrewScreen; },
                          [=] { lv_label_set_text(ui_BrewScreen_profileName, selectedProfile.label.c_str()); },
                          &selectedProfileId);

    effect_mgr.use_effect(
        [=] { return currentScreen == ui_ProfileScreen; },
        [=] {
            if (profileLoaded) {
                _ui_flag_modify(ui_ProfileScreen_profileDetails, LV_OBJ_FLAG_HIDDEN, _UI_MODIFY_FLAG_REMOVE);
                _ui_flag_modify(ui_ProfileScreen_loadingSpinner, LV_OBJ_FLAG_HIDDEN, _UI_MODIFY_FLAG_ADD);
                lv_label_set_text(ui_ProfileScreen_profileName, currentProfileChoice.label.c_str());

                const auto minutes = static_cast<int>(currentProfileChoice.getTotalDuration() / 60.0 - 0.5);
                const auto seconds = static_cast<int>(currentProfileChoice.getTotalDuration()) % 60;
                lv_label_set_text_fmt(ui_ProfileScreen_targetDuration2, "%2d:%02d", minutes, seconds);
                lv_label_set_text_fmt(ui_ProfileScreen_targetTemp2, "%d°C", static_cast<int>(currentProfileChoice.temperature));
                unsigned int phaseCount = currentProfileChoice.getPhaseCount();
                unsigned int stepCount = currentProfileChoice.phases.size();
                lv_label_set_text_fmt(ui_ProfileScreen_stepsLabel, "%d step%s", stepCount, stepCount > 1 ? "s" : "");
                lv_label_set_text_fmt(ui_ProfileScreen_phasesLabel, "%d phase%s", phaseCount, phaseCount > 1 ? "s" : "");
            } else {
                _ui_flag_modify(ui_ProfileScreen_profileDetails, LV_OBJ_FLAG_HIDDEN, _UI_MODIFY_FLAG_ADD);
                _ui_flag_modify(ui_ProfileScreen_loadingSpinner, LV_OBJ_FLAG_HIDDEN, _UI_MODIFY_FLAG_REMOVE);
            }

            ui_object_set_themeable_style_property(ui_ProfileScreen_previousProfileBtn, LV_PART_MAIN | LV_STATE_DEFAULT,
                                                   LV_STYLE_IMG_RECOLOR,
                                                   currentProfileIdx > 0 ? _ui_theme_color_NiceWhite : _ui_theme_color_SemiDark);
            ui_object_set_themeable_style_property(ui_ProfileScreen_previousProfileBtn, LV_PART_MAIN | LV_STATE_DEFAULT,
                                                   LV_STYLE_IMG_RECOLOR_OPA,
                                                   currentProfileIdx > 0 ? _ui_theme_alpha_NiceWhite : _ui_theme_alpha_SemiDark);
            ui_object_set_themeable_style_property(
                ui_ProfileScreen_nextProfileBtn, LV_PART_MAIN | LV_STATE_DEFAULT, LV_STYLE_IMG_RECOLOR,
                currentProfileIdx < favoritedProfiles.size() - 1 ? _ui_theme_color_NiceWhite : _ui_theme_color_SemiDark);
            ui_object_set_themeable_style_property(
                ui_ProfileScreen_nextProfileBtn, LV_PART_MAIN | LV_STATE_DEFAULT, LV_STYLE_IMG_RECOLOR_OPA,
                currentProfileIdx < favoritedProfiles.size() - 1 ? _ui_theme_alpha_NiceWhite : _ui_theme_alpha_SemiDark);
        },
        &currentProfileId, &profileLoaded);
}

void DefaultUI::handleScreenChange() {
    lv_obj_t *current = lv_scr_act();

    if (current != *targetScreen) {
        if (*targetScreen == ui_StandbyScreen) {
            standbyEnterTime = millis();
        } else if (current == ui_StandbyScreen) {
            const Settings &settings = controller->getSettings();
            setBrightness(settings.getMainBrightness());
        }

        _ui_screen_change(targetScreen, LV_SCR_LOAD_ANIM_NONE, 0, 0, targetScreenInit);
        _ui_screen_delete(&current);
        rerender = true;
    }
}

void DefaultUI::updateStandbyScreen() {
    if (standbyEnterTime > 0) {
        const Settings &settings = controller->getSettings();
        const unsigned long now = millis();
        if (now - standbyEnterTime >= settings.getStandbyBrightnessTimeout()) {
            setBrightness(settings.getStandbyBrightness());
        }
    }

    if (!apActive && WiFi.status() == WL_CONNECTED) {
        time_t now;
        struct tm timeinfo;

        localtime_r(&now, &timeinfo);
        // allocate enough space for both 12h/24h time formats
        if (getLocalTime(&timeinfo, 500)) {
            char time[9];
            Settings &settings = controller->getSettings();
            const char *format = settings.isClock24hFormat() ? "%H:%M" : "%I:%M %p";
            strftime(time, sizeof(time), format, &timeinfo);
            lv_label_set_text(ui_StandbyScreen_time, time);
            lv_obj_clear_flag(ui_StandbyScreen_time, LV_OBJ_FLAG_HIDDEN);
        }
    } else {
        lv_obj_add_flag(ui_StandbyScreen_time, LV_OBJ_FLAG_HIDDEN);
    }
    controller->getClientController()->isConnected() ? lv_obj_clear_flag(ui_StandbyScreen_bluetoothIcon, LV_OBJ_FLAG_HIDDEN)
                                                     : lv_obj_add_flag(ui_StandbyScreen_bluetoothIcon, LV_OBJ_FLAG_HIDDEN);
    !apActive &&WiFi.status() == WL_CONNECTED ? lv_obj_clear_flag(ui_StandbyScreen_wifiIcon, LV_OBJ_FLAG_HIDDEN)
                                              : lv_obj_add_flag(ui_StandbyScreen_wifiIcon, LV_OBJ_FLAG_HIDDEN);
}

void DefaultUI::updateStatusScreen() const {
    Process *process = controller->getProcess();
    if (process == nullptr) {
        process = controller->getLastProcess();
    }
    if (process->getType() != MODE_BREW) {
        return;
    }
    auto *brewProcess = static_cast<BrewProcess *>(process);
    const auto phase = brewProcess->currentPhase;

    unsigned long now = millis();
    if (!process->isActive()) {
        now = brewProcess->finished;
    }

    lv_label_set_text(ui_StatusScreen_stepLabel, phase.phase == PhaseType::PHASE_TYPE_BREW ? "BREW" : "INFUSION");
    lv_label_set_text(ui_StatusScreen_phaseLabel, brewProcess->isActive() ? phase.name.c_str() : "Finished");

    const unsigned long processDuration = now - brewProcess->processStarted;
    const double processSecondsDouble = processDuration / 1000.0;
    const auto processMinutes = static_cast<int>(processSecondsDouble / 60.0);
    const auto processSeconds = static_cast<int>(processSecondsDouble) % 60;
    lv_label_set_text_fmt(ui_StatusScreen_currentDuration, "%2d:%02d", processMinutes, processSeconds);

    if (brewProcess->target == ProcessTarget::VOLUMETRIC && phase.hasVolumetricTarget()) {
        Target target = phase.getVolumetricTarget();
        lv_bar_set_value(ui_StatusScreen_brewBar, brewProcess->currentVolume, LV_ANIM_OFF);
        lv_bar_set_range(ui_StatusScreen_brewBar, 0, target.value + 1);
        lv_label_set_text_fmt(ui_StatusScreen_brewLabel, "%.1fg", target.value);
    } else {
        const unsigned long progress = now - brewProcess->currentPhaseStarted;
        lv_bar_set_value(ui_StatusScreen_brewBar, progress, LV_ANIM_OFF);
        lv_bar_set_range(ui_StatusScreen_brewBar, 0, std::max(static_cast<int>(brewProcess->getPhaseDuration()), 1));
        lv_label_set_text_fmt(ui_StatusScreen_brewLabel, "%ds", brewProcess->getPhaseDuration() / 1000);
    }

    if (brewProcess->target == ProcessTarget::TIME) {
        const unsigned long targetDuration = brewProcess->getTotalDuration();
        const double targetSecondsDouble = targetDuration / 1000.0;
        const auto targetMinutes = static_cast<int>(targetSecondsDouble / 60.0);
        const auto targetSeconds = static_cast<int>(targetSecondsDouble) % 60;
        lv_label_set_text_fmt(ui_StatusScreen_targetDuration, "%2d:%02d", targetMinutes, targetSeconds);
    } else {
        lv_label_set_text_fmt(ui_StatusScreen_targetDuration, "%.1fg", brewProcess->getBrewVolume());
    }
    lv_img_set_src(ui_StatusScreen_Image8, brewProcess->target == ProcessTarget::TIME ? &ui_img_360122106 : &ui_img_1424216268);

    if (brewProcess->isAdvancedPump()) {
        float pressure = brewProcess->getPumpPressure();
        const double percentage = 1.0 - static_cast<double>(pressure) / static_cast<double>(pressureScaling);
        adjustTarget(uic_StatusScreen_dials_pressureTarget, percentage, -62.0, 124.0);
    } else {
        const double percentage = 1.0 - 0.5;
        adjustTarget(uic_StatusScreen_dials_pressureTarget, percentage, -62.0, 124.0);
    }

    // Brew finished adjustments
    if (process->isActive()) {
        lv_obj_add_flag(ui_StatusScreen_brewVolume, LV_OBJ_FLAG_HIDDEN);
    } else {
        if (brewProcess->target == ProcessTarget::VOLUMETRIC) {
            lv_obj_clear_flag(ui_StatusScreen_brewVolume, LV_OBJ_FLAG_HIDDEN);
        }
        lv_obj_add_flag(ui_StatusScreen_barContainer, LV_OBJ_FLAG_HIDDEN);
        lv_obj_add_flag(ui_StatusScreen_labelContainer, LV_OBJ_FLAG_HIDDEN);
        lv_label_set_text_fmt(ui_StatusScreen_brewVolume, "%.1lfg", brewProcess->currentVolume);
        lv_imgbtn_set_src(ui_StatusScreen_pauseButton, LV_IMGBTN_STATE_RELEASED, nullptr, &ui_img_631115820, nullptr);
    }
}

void DefaultUI::adjustDials(lv_obj_t *dials) {
    lv_obj_t *tempGauge = ui_comp_get_child(dials, UI_COMP_DIALS_TEMPGAUGE);
    lv_obj_t *tempText = ui_comp_get_child(dials, UI_COMP_DIALS_TEMPTEXT);
    lv_obj_t *pressureTarget = ui_comp_get_child(dials, UI_COMP_DIALS_PRESSURETARGET);
    lv_obj_t *pressureGauge = ui_comp_get_child(dials, UI_COMP_DIALS_PRESSUREGAUGE);
    lv_obj_t *pressureText = ui_comp_get_child(dials, UI_COMP_DIALS_PRESSURETEXT);
    _ui_flag_modify(pressureTarget, LV_OBJ_FLAG_HIDDEN, pressureAvailable);
    _ui_flag_modify(pressureGauge, LV_OBJ_FLAG_HIDDEN, pressureAvailable);
    _ui_flag_modify(pressureText, LV_OBJ_FLAG_HIDDEN, pressureAvailable);
    lv_obj_set_x(tempText, pressureAvailable ? -50 : 0);
    lv_obj_set_y(tempText, pressureAvailable ? -205 : -180);
    lv_arc_set_bg_angles(tempGauge, 118, pressureAvailable ? 242 : 62);
    lv_arc_set_range(pressureGauge, 0, pressureScaling * 10);
}

inline void DefaultUI::adjustTempTarget(lv_obj_t *dials) {
    double gaugeAngle = pressureAvailable ? 124.0 : 304;
    double gaugeStart = pressureAvailable ? 118.0 : -62;
    double percentage = static_cast<double>(targetTemp) / 160.0;
    lv_obj_t *tempTarget = ui_comp_get_child(dials, UI_COMP_DIALS_TEMPTARGET);
    adjustTarget(tempTarget, percentage, gaugeStart, gaugeAngle);
}

void DefaultUI::applyTheme() {
    const Settings &settings = controller->getSettings();
    int newThemeMode = settings.getThemeMode();

    if (newThemeMode != currentThemeMode) {
        currentThemeMode = newThemeMode;
        ui_theme_set(currentThemeMode);
    }
}

void DefaultUI::adjustTarget(lv_obj_t *obj, double percentage, double start, double range) const {
    double angle = start + range - range * percentage;

    lv_img_set_angle(obj, angle * -10);
    int x = static_cast<int>(std::cos(angle * M_PI / 180.0f) * 235.0);
    int y = static_cast<int>(std::sin(angle * M_PI / 180.0f) * -235.0);
    lv_obj_set_pos(obj, x, y);
}

void DefaultUI::loopTask(void *arg) {
    auto *ui = static_cast<DefaultUI *>(arg);
    while (true) {
        ui->loop();
        vTaskDelay(25 / portTICK_PERIOD_MS);
    }
}

void DefaultUI::profileLoopTask(void *arg) {
    auto *ui = static_cast<DefaultUI *>(arg);
    while (true) {
        ui->loopProfiles();
        vTaskDelay(25 / portTICK_PERIOD_MS);
    }
}
