mikld86/GMTiredandForked/(commit log)

2024-10-28 fix: Fix relay function
    [Controller.cpp]
2024-10-28 fix: Fix new pump logic
2024-10-28 fix: Try fix steam
    [Controller.cpp]
2024-10-28 feat: Add homekit integration
    [Gaggimate.kicad_pcb]
2024-10-28 feat: Persist temperature and duration over restarts
2024-10-29 feat: Shrink PCB by 16mm
    [Gaggimate.kicad_pcb, Gaggimate.kicad_sch]
2024-10-29 feat: Change USB routing on PCB
    [Gaggimate.kicad_pcb, Gaggimate.kicad_sch]
2024-10-30 feat: Add settings screen, temperature offset, fix UI
    [Controller.cpp, Controller.h]
2024-10-30 feat: Add wifi and bluetooth indicator Fixes #3
    [Controller.cpp]
2024-10-30 feat: Display temperature with offset
2024-10-31 fix: Fix PCB buttons, traces
    [Gaggimate.kicad_pcb, Gaggimate.kicad_sch]
2024-10-31 feat: Add WiFi AP mode, version, PID settings
2024-10-31 fix: Fix index_html rendering
    [Controller.cpp]
2024-11-04 feat: Add button connector to PCB, change pcbdraw
    [Gaggimate.kicad_pcb, Gaggimate.kicad_sch]
2024-11-04 feat: Add ESP32 image
2024-11-04 feat: Replace diodes with usb protection chip
    [Gaggimate.kicad_pcb, Gaggimate.kicad_sch]
2024-11-07 fix: Conditionally enable homekit
    [Controller.cpp]
2024-11-07 fix: Don't run loop before setup
    [Controller.cpp, Controller.h, HomekitPlugin.cpp, HomekitPlugin.h, PluginManager.h]
2024-11-07 fix: Fix memory leaks
    [HomekitPlugin.cpp, HomekitPlugin.h]
2024-11-08 fix: add clang-tidy fix
    [Controller.cpp]
2024-11-12 feat: Simplify MAX31885 circuit, add silkscreen pinout
    [Gaggimate.kicad_pcb, Gaggimate.kicad_sch]
2024-11-15 feat: Fix PCB label, add render
    [Gaggimate.kicad_pcb, Gaggimate.kicad_sch]
2024-11-18 feat: Add new STLs
    [case_back.stl, case_front.stl, electronics_mount.stl, pcb_base.stl, pcb_cover.stl]
2024-11-19 feat: Add expansion mounting hole to PCB, add expansion template
    [Gaggimate.kicad_pcb, Gaggimate.kicad_sch, gaggimate-expansion-template.kicad_pcb, gaggimate-expansion-template.kicad_sch]
2024-11-20 feat: Add adjustments to PCB, pcb diff pipeline
    [Gaggimate.kicad_pcb, Gaggimate.kicad_sch]
2024-11-21 fix: Add more footprints for pinout
2024-11-21 fix: Fix homekit settings
    [Settings.cpp]
2024-11-21 fix: Fix favicon and host
    [WebUIPlugin.cpp]
2024-11-22 feat: Adjust platformio build and software for PCB
2024-11-22 feat: Replace 10uF output capacitor with 22uF
    [Gaggimate.kicad_pcb, Gaggimate.kicad_sch]
2024-11-23 feat: Add grinding feature
    Fixes #6
    [Controller.cpp, Controller.h, Settings.cpp, Settings.h]
2024-11-24 feat: Move MAX31885, add SDA2, add silkscreen adjustments
    [Gaggimate.kicad_pcb, Gaggimate.kicad_sch]
2024-11-24 feat: Move connectors from AC, adjust logo
2024-11-24 fix: Exchange switch for correct model
    [BOM-Gaggimate.csv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]
2024-11-24 fix: Move back connectors to allow expansion to fit
    [BOM-Gaggimate.csv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]
2024-11-24 fix: Retract ground plane a bit
    [Gaggimate-CuBottom.gbr, Gaggimate-CuTop.gbr, Gaggimate-EdgeCuts.gbr, Gaggimate-MaskBottom.gbr, Gaggimate-MaskTop.gbr, Gaggimate-NPTH.drl, Gaggimate-PTH.drl, Gaggimate-PasteBottom.gbr]
2024-11-24 fix: Fix AC line
    [Gaggimate-CuBottom.gbr, Gaggimate-CuTop.gbr, Gaggimate-EdgeCuts.gbr, Gaggimate-MaskBottom.gbr, Gaggimate-MaskTop.gbr, Gaggimate-NPTH.drl, Gaggimate-PTH.drl, Gaggimate-PasteBottom.gbr]
2024-11-24 fix: Fix via in pad
    [Gaggimate-CuBottom.gbr, Gaggimate-CuTop.gbr, Gaggimate-EdgeCuts.gbr, Gaggimate-MaskBottom.gbr, Gaggimate-MaskTop.gbr, Gaggimate-NPTH.drl, Gaggimate-PTH.drl, Gaggimate-PasteBottom.gbr]
2024-11-26 chore: Fix sonarqube issues #1
    [Controller.cpp, Controller.h, PluginManager.cpp]
2024-11-26 chore: Fix sonarqube issues #2
    [PluginManager.cpp]
2024-11-26 chore: Fix sonarqube issues #3
2024-11-26 chore: Fix sonarqube issues #4
    [Controller.cpp, Event.h, HomekitPlugin.cpp, HomekitPlugin.h]
2024-11-26 chore: Fix sonarqube issues #5
2024-11-26 feat: Add CAD files for PCB case and screen
    [Display Case.step]
2024-11-27 feat: Rework OTA library, use SPIFFS for web
    [Controller.cpp, HomekitPlugin.cpp, WebUIPlugin.cpp, WebUIPlugin.h]
2024-11-27 fix: Fix sonarqube errors
2024-11-27 fix: Fix more sonarqube errors
2024-11-27 doc: Add sonarqube badges
2024-11-28 feat: Replace entire Web UI with PReact app
    [Controller.h, WebUIPlugin.cpp]
2024-12-02 feat: Add missing components to BOM
2024-12-02 fix: Fix pinout diagram for new PCB layout
2024-12-02 feat: Add wiring diagrams
    [classic.bom.tsv, classicpro.bom.tsv]
2024-12-02 feat: Add clipped pcb case to avoid screws and heatsets
    [pcb_clipped_base.stl, pcb_clipped_cover.stl]
2024-12-11 fix: Fix rotation calculation
    [Controller.cpp]
2024-12-11 fix: Fix web ui plugin
    [WebUIPlugin.h]
2024-12-17 fix: Remove slow animations, fix lvgl settings, fix slow AP mode
    [Controller.cpp, Controller.h, HomekitPlugin.cpp, LV_Helper.cpp, WebUIPlugin.h, mDNSPlugin.cpp, mDNSPlugin.h]
2024-12-18 fix: Fix losing duration on water screen
    [Controller.cpp]
2024-12-26 Added variant without screwholes
    This screen backplate model fits the GCP better, by having magnets placed lower. This is a version without screw holes.
    [Case-back-noScrewholes.stl, Screen Backplate - no screwholes.step]
2024-12-26 Added model with screwholes
    The same screenbackplate, but with holes to mount the screen with screws.
    [Case-back-withScrewholes.stl.stl, Screen Backplate - With screwholes.step]
2025-01-10 feat: Add angled screen case
    [Angled Display Case.step, case_back_gaggia_classic.stl, case_back_gaggia_classic_pro.stl, case_back_rancilio_silvia.stl]
2025-01-11 feat: Use flex for menu, unload screens
    [Controller.cpp, Controller.h, DefaultUI.cpp, DefaultUI.h, LV_Helper.h, LilyGo_Display.h, LilyGo_RGBPanel.h]
2025-01-14 feat: Rework UI, add waveshare driver, add BLE preparation
    [BLEScalePlugin.cpp, BLEScalePlugin.h, Controller.cpp, DefaultUI.cpp, DefaultUI.h, Driver.h, I2C_Driver.cpp]
2025-01-17 fix: Fix waveshare driver
    [DefaultUI.cpp, DefaultUI.h, WavesharePanel.cpp, WavesharePanel.h, utilities.h]
2025-01-17 fix: Add working waveshare 2.8 inch driver
    [WavesharePanel.cpp, utilities.h]
2025-01-18 feat: Add 2.1 inch panel to waveshare driver
2025-01-18 feat: Allow skipping preinfusion
    [DefaultUI.cpp, Process.h]
2025-01-18 feat: Add waveshare panel driver
2025-01-20 fix: Clean up brew phase code
    [DefaultUI.cpp, DefaultUI.h]
2025-01-25 fix: Fix pid bug with temp offset
    [Controller.cpp]
2025-01-30 fix: Fix double call to target volume
    [Controller.cpp]
2025-01-30 feat: Pre-infusion now pumps with the valve open
2025-02-01 fix: Fix averaging flow
    [Process.h]
2025-02-01 fix: Raise predictive time
    [Process.h]
2025-02-01 fix: Fix boiler fill event on startup
    [BoilerFillPlugin.cpp, BoilerFillPlugin.h, Controller.cpp]
2025-02-01 Fixed case-typo
2025-02-01 fix: Fix sonarqube findings
    [MQTTPlugin.cpp, MQTTPlugin.h]
2025-02-01 fix: Remove code duplication
    [MQTTPlugin.cpp, MQTTPlugin.h]
2025-02-01 fix: Fix sonarqube issue
    [MQTTPlugin.h]
2025-02-01 fix: Fix header declaration
    [WebUIPlugin.h]
2025-02-04 feat: Upgrade expansion template to IO extender version
    [gaggimate-expansion-template.kicad_pcb, gaggimate-expansion-template.kicad_sch]
2025-02-04 fix: Use flex grow for progress bars instead of pixels
    [WebUIPlugin.cpp]
2025-02-04 feat: Throttle temperature updates by only publishing actual changes
2025-02-05 fix: Fix predictive flow
    [Process.h]
2025-02-05 fix: Fix grind predictive scales
    [Process.h]
2025-02-11 fix: Cleanup before board v2
    [BOM-Gaggimate.csv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]
2025-03-09 feat: Add felicita arc, fix Eureka scales
    [BLEScalePlugin.cpp]
2025-03-15 feat: Add button control (#139)
    * added brew button on
    * brew button functionality
    * added steam button actions
    * revert dev changes
    * revert
    * feat: Finish button control code
    * chore: Reformat code
    * fix: Rename button methods
    ---------
    [Controller.cpp, Controller.h, MQTTPlugin.cpp, Settings.cpp, Settings.h, WebUIPlugin.cpp]
2025-03-15 feat: Add predictive shutoff for weight based brewing (#140)
    * feat: Add shutoff and volume rate prediction (#106)
    * changed prediction to linear fit to last n (default 2) measurements and use actual measurement time
    * moved calculation to reduce number of calls
    * store measurements; first small changes for delay calculation
    * fixes
    * switched to time window for prediction, updated GrindProcess
    * small edits
    * some edits/fixes
    * added update of delays 2s after processes become inactive
    * moved linear fit to a new header file
    * feat: Rework predictive code
    ---------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
    [Controller.cpp, Process.h, Settings.cpp, Settings.h, predictive.h]
2025-03-15 feat: Start reworking controller code, move it into sub-project (#46)
    * feat: Start reworking controller code, move it into sub-project
    * feat: Add board autodetection
    * chore: Fix build, format
    * feat: Add new board version
2025-03-16 feat: Add temperature graph to web ui (#143)
2025-03-16 feat: Rework OTA, allow flashing controller (#148)
    * feat: Rework OTA, allow flashing controller
    * fix: Add fixes for OZTA
    * fix: Fix issues with OTA
    [Controller.cpp, Controller.h, WebUIPlugin.cpp, WebUIPlugin.h]
2025-03-16 feat: Raise weight output limit to 250 (#149)
    Fixes #138
    [constants.h]
2025-03-17 feat: Rework everything into peripherals (#150)
    * feat: Raise weight output limit to 250
    * feat: Move everything into peripherals
    Fixes #78
    * fix: Remove unnecessary commentsg
    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
    [Controller.cpp]
2025-03-17 feat: Add pressure and dimmer peripheral (#151)
    * feat: Add pressure and dimmer peripheral
    Fixes #87
    * fix: Add back version
2025-03-17 fix: Fix captive portal (#152)
    * fix: Fix captive portal
    * fix: Remove unused HTML
    [Controller.cpp, Controller.h, WebUIPlugin.cpp, WebUIPlugin.h]
2025-03-17 fix: Fix wifi bug
    [Controller.cpp]
2025-03-18 fix: Fix OTA, protocol errors, scale prediction (#154)
    * fix: Fix OTA, protocol errors
    * chore: Format, remove debug logging
    * fix: Fix scale prediction logic
    [Controller.cpp, Controller.h, PluginManager.cpp, Process.h, Settings.cpp, WebUIPlugin.cpp]
2025-03-18 fix: Fix hanging NTP (#155)
    Set delay with slow ntp connections to 50ms max
    Fixes #146
    [DefaultUI.cpp]
2025-03-19 fix: Add LPF for heater
2025-03-19 fix: Disable heater on timeout
2025-03-19 fix: Fix heater, add debug logging
    [Process.h]
2025-03-19 feat: Fix v1.4.0 bugs, add better scale and grind control (#158)
    [BLEScalePlugin.cpp, BLEScalePlugin.h, Controller.cpp, Process.h, Settings.cpp, Settings.h, SmartGrindPlugin.cpp, SmartGrindPlugin.h]
2025-04-01 WebUI & OTA Overhaul (#166)
    * feat: Overhaul Web UI, improve OTA
    * fix: Add more components for profiles
    * fix: Skip one auto OTA
    * fix: Fix delay
    [Controller.cpp, WebUIPlugin.cpp, WebUIPlugin.h]
2025-04-01 feat: Automatically run autotune on machine startup (#167)
    * feat: Automatically startup heater in autotune mode
    * fix: Fix board value
2025-04-01 fix: Fix jumping into brewscreen (#168)
    Fixes #160
    [DefaultUI.cpp]
2025-04-01 fix: Switch back to PID loop
2025-04-02 feat: Add new STL files
    [case_back.stl, case_back_gaggia_classic.stl, case_back_gaggia_classic_pro.stl, case_back_rancilio_silvia.stl, case_front.stl, pcb_base.stl, pcb_base_clipped.stl, pcb_clipped_base.stl]
2025-04-06 feat: Fix pressing through wakeup, adjust button borders (#170)
    [WebUIPlugin.cpp]
2025-04-06 feat: Allow setting timezone via Web UI (#171)
    * feat: Fix pressing through wakeup, adjust button borders
    * feat: Allow setting the timezone via Web UI
    [Controller.cpp, Settings.cpp, Settings.h, WebUIPlugin.cpp, constants.h, zones.h]
2025-04-06 feat: Make standby timeout configurable (#172)
    Fixes #120
    [Controller.cpp, Settings.cpp, Settings.h, WebUIPlugin.cpp, constants.h]
2025-04-07 feat: Add error display, update display, controller reconnect (#174)
    Fixes #4, #61
    [Controller.cpp, DefaultUI.cpp, DefaultUI.h]
2025-04-10 feat: Add PID Autotune (#176)
    * feat: Add profile edit screen
    * feat: Add PID Autotune
    * fix: Hide future menu options again
    * fix: Remove unused css
    [classicpro.bom.tsv]
2025-04-15 fix: Fix some bugs
    [Controller.cpp]
2025-04-22 fix: Change stl files for pcb enclosures
    [pcb_base_clipped.stl, pcb_cover_clipped_[support].stl]
2025-05-19 fix: Fix PID heater
2025-05-21 fix: Fix nightly bugs
    [Settings.cpp, WebUIPlugin.cpp, constants.h]
2025-05-22 fix: Fix standby timeout
    [Settings.cpp]
2025-05-24 feat: Add pressure gauge, optimize communication (#205)
    * feat: Add pressure display
    * feat: Merge sensor and control data
    * feat: Adjust UI depending on board version
2025-05-29 feat: Improve/fix pump on standard v2, cleanup BLE comms (#210)
2025-06-03 Add Feature: customize pressure sensor scaling (#225)
    * feat: Try out Nimrod PID library
    * Fix for acaia pearl s scale
    * quick hack for 12 bar pressure sensor
    * Revert "feat: Try out Nimrod PID library"
    This reverts commit b539c8980746967338ea3cfbfa956cf69a72c57c.
    * Revert "quick hack for 12 bar pressure sensor"
    This reverts commit f4b5a6e22afaea68f35b8dac588118365b2ae321.
    * Added a setting for 12/16 bar pressure sensor; change to this setting requires reboot.
    * changed to manual entry on web page, fixed value not being saved, value is still not being properly set.
    * Changed data type from byte array to string representation of float value when sending pressureScaling between clien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
    [Controller.cpp, Controller.h, Settings.cpp, Settings.h, WebUIPlugin.cpp, constants.h]
2025-06-03 feat: Try out Nayrods PID library (#223)
    * fix: Rename PID lib
    * feat: Publish artifacts to GH-pages
    * fix: Fix PR workflow
    * fix: Fix case
    * feat: Add required confirmations as controllable
    * fix: Fix simplepid setpoint filter
    * Update Nayrod PID (#226)
    * Add user tunner parameter/ changed thresholds for autotune+safety detection/tested setpoint filter and feedforward
    * Autotune calculation
    * Switch setpoint filter for second order filter
    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
2025-06-03 fix: Remove extra options from pid
2025-06-03 fix: Fix default PID values
    [constants.h]
2025-06-06 feat: Introduce profiles (#175)
    * fix: Fix merge errors
    * feat: Add new profile screen
    * fix: Fix PID heater
    * feat: Add profile progress
    * feat: Repair code after cherrypicking, finish touch ui, add migration
    * feat: Tune pump control, extend protocol
    * feat: Add functioning web ui
    * feat: Add web ui fixes, reflect profile on screen
    * feat: Add favorite function
    * fix: Fix communication
    * feat: Finalize profiles with pressure
    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
    [Controller.cpp, Controller.h, DefaultUI.cpp, DefaultUI.h, Process.h, ProfileManager.cpp, ProfileManager.h]
2025-06-06 fix: Add improved pump control
2025-06-06 fix: Prevent empty favorites
    [DefaultUI.cpp, ProfileManager.cpp, ProfileManager.h]
2025-06-06 fix: Fix display bugs in profiles
    [DefaultUI.cpp]
2025-06-09 fix: Revert changes to pump
2025-06-12 fix: Fix BLE communication delays (#239)
    * fix: Fix BLE communication delays
    * fix: Fix wrong import
    [Controller.cpp, Controller.h, DefaultUI.cpp]
2025-06-14 fix: Fix waveshare panel
    [WavesharePanel.cpp]
2025-06-14 Pressure scaling UI fixes (#235)
    * feat: Introduce profiles (#175)
    * Revert "feat: Introduce profiles (#175)"
    This reverts commit 27d7e809706613b02c70ae091e312954ae1913ea.
    * Adjust UI pressure scale gauge with pressure scaling factor stored in settings.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
    [DefaultUI.cpp, DefaultUI.h]
2025-06-15 fix: Fix pump power, grind volume setting
    [Controller.cpp, DefaultUI.cpp, constants.h]
2025-06-16 feat: Add Nayrods pump control, flow estimation and volume estimation (#251)
    * feat: Add Nayrods pump control, flow estimation and volume estimation
    * fix: Fix test warning
    * fix: Fix volume estimation
    * feat: Add pressure and flow graphs to web ui
    * fix: Fix controller usage
    [BLEScalePlugin.cpp, Controller.cpp, Controller.h, WebUIPlugin.cpp, WebUIPlugin.h]
2025-06-16 fix: Fine-tune new pump library
2025-06-16 fix: Try fix wifi issues
    [Controller.cpp]
2025-06-27 Feature/standby brightness reduction (#266)
    * cpp side impl
    * webui side
    * Fix bad unstash
    * Add zero standby brightness
    * Claude to include a toggle
    * Move standby brightness handling to updateStandbyScreen
    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
    [DefaultUI.cpp, DefaultUI.h, Driver.h, LilyGoDriver.h, Settings.cpp, Settings.h, WaveshareDriver.h, WebUIPlugin.cpp]
2025-06-27 Update Autotune.cpp (#250)
    To account for Silvia heating super constant
2025-06-27 Further enhance pump controls (#273)
    * feat: Pump precision (#264)
    * Improve overshoot and time response of pressure control
    * Fixed virtualscale flow spikes and zero artefact in virtualscale() function
    * changed OPVValve to valve
    * Fixed error in antiwindup
    * fix: Fix freertos calls
    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
2025-06-29 feat: Steam Rework and temperature indicator (#277)
    * feat: Redesign UI for new steam mode
    * Make it green (when ready) (#272)
    * feat: Add UI Changes
    * feat: Make steam pump percentage adjustable
    * feat: Change button control for steam mode
    * feat: Major UI speedup, add auto steam
    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
    [Controller.cpp, Controller.h, DefaultUI.cpp, DefaultUI.h, LilyGoDriver.h, Settings.cpp, Settings.h]
2025-06-30 fix: Fix half timezones
    [zones.h]
2025-06-30 fix: Update asynctcp, fix websocket reconnect
    [WebUIPlugin.cpp, WebUIPlugin.h]
2025-06-30 fix: Fix settings for volumetric target and pressure
    Fixes #270, #275
2025-06-30 fix: Hide wifi password in AP mode
    Fixes #257
    [WebUIPlugin.cpp, WebUIPlugin.h]
2025-06-30 fix: Make pressure bar smoother
    [DefaultUI.cpp]
2025-06-30 fix: Autoconnect scale when startup mode is brew (#280)
    [BLEScalePlugin.cpp]
2025-07-09 Hydraulic estimation Kalman based, turbulent flow model
2025-07-09 get pump cmd for flow control
2025-07-09 Implement async WiFi manager (#293)
    * Refine WiFi manager and restart network services
    * fix: Fix wifi manager issues, deprecations
    [Controller.cpp, Controller.h, HomekitPlugin.cpp, LilyGo_RGBPanel.cpp, LilyGo_RGBPanel.h, Settings.cpp, Settings.h, WavesharePanel.cpp]
2025-07-09 fix: Fix wrong flow when no brew is running
2025-07-10 fix: Initialize wifi last
    [Controller.cpp, WifiManager.cpp]
2025-07-10 web: add duplicate profile button (#298)
2025-07-10 fix: Fix too verbose error logging
    [Controller.cpp]
2025-07-11 fix: Replace wifi manager
    [Controller.cpp, Controller.h, WifiManager.cpp, WifiManager.h]
2025-07-12 fix: Add back NTP setting
    [DefaultUI.cpp]
2025-07-13 fix: Improve heater safeguards (#304)
2025-07-13 feat: Revert wifi manager, use simple wifi
    [Controller.cpp, Controller.h, HomekitPlugin.cpp, Settings.cpp, WebUIPlugin.cpp, WifiManager.cpp, WifiManager.h, constants.h]
2025-07-14 fix: Use log tag in controller
    [Controller.cpp, Controller.h, WifiManager.cpp, WifiManager.h]
2025-07-14 Add display theme application via WebUI (#282)
    * Add theme application
    * Revert SLS edit
    * Fix newlines
    * Fix settings, change colors
    * No need to trigger dirty
    [DefaultUI.cpp, DefaultUI.h, Settings.cpp, Settings.h, WebUIPlugin.cpp]
2025-07-14 fix: Fix pump calls, send pump flow rate
2025-07-14 feat: Add first shot on history (#297)
    * feat: Add first shot on history
    * fix: Fix too verbose logging
    * fix: Fix too verbose error logging
    * feat: Finish first shot of shot history
    * fix: Fix data change
    * fix: Fix estimator
    [BLEScalePlugin.cpp, Controller.cpp, Controller.h, DefaultUI.cpp, Settings.cpp, Settings.h, ShotHistoryPlugin.cpp, ShotHistoryPlugin.h]
2025-07-16 Changed ESP_PANEL_LCD_RGB_TIMING_FREQ_HZ (#306)
    * Update BLEScalePlugin.cpp for WeighMyBru Scale Support
    * Added WeighMyBru Scale Support & Updated platformio.ini
    * Add GitHub Pages firmware flasher
    * Fixed URL for flashing
    * Auto-update firmware files [skip ci]
    * Auto-update firmware files [skip ci]
    * Fixed OTA URL
    * Auto-update firmware files [skip ci]
    * Update OTA system to point to fork and add complete firmware files
    - Modified OTA URL in WebUIPlugin.h to point to fork instead of original repo
    - Updated GitHub link in web UI Header.jsx
    - Added complete firmware files for OTA: display-firmware.bin, display-filesystem.bin, board-firmware.bin
    - Built and included SPIFFS filesystem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
    [utilities.h]
2025-07-17 Move Save Preferences button on OTA page and fix overflow issues (#305)
    * move "Save preferences" button on OTA page, fix overflow issues on OTA and Settings page
    The only real changes are to /web/src/pages/OTA/index.jsx and /web/src/pages/Settings/index.jsx, the rest are from running the prettier command
    Moved the "Save preferences" button to the div containing the Update channel selector to clarify that the button saves the update channel chosen
    Added flex-wrap and gap-y-2 to the div containing the Update-buttons to allow the buttons to stack vertically when there is not enough width to stack them horizontally
    * change flex gap to gap-y-1 on container for Update-buttons to match gap be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
2025-07-17 fix: Fix buttons on mobile devices
2025-07-23 Tailwind and Vite upgrade (#318)
    * update vite
    * Upgrade TailwindCSS and Vite
    Upgraded to Tailwind v4
    Upgraded to Vite v7
    Removed PostCSS as its no longer required by tailwind
    updated styles to conform to tailwind requirements not totally sure what you want on the border as border-opacity is depreciated
    * Updated to per CodeRabbit
    this is how i tried it originally and it didn't work but idk it does now.
    * Update package.json
    * Add back safelist and font family.
    Also remove flowbite as its not used.
2025-07-23 fix: Add back smoothing in pressure controller (#319)
2025-07-26 feat: Allow flow control with pressure limit (#320)
    * feat: Allow flow control with pressure limit
    * fix: Cleanup unused code
    * feat: Allow controlling flow from profile
    * fix: Add codereview feedback
    * fix: Fix unused variable
    * fix: Fix flow control to use pump not puck flow
    * feat: Add UI for flow
    * fix: Small fixes to pressure controller
    * fix: Remove console.log
    * fix: Fix wrong attribute
    * fix: Fix volumetric target
    [Controller.cpp, DefaultUI.cpp, Process.h]
2025-07-27 fix: Feed back manual control into pressure controller (#324)
2025-07-27 Implement support for 1.43 inch LilyGo T-Display S3 AMOLED (DS) (#218)
    * Add the board
    * Basic Panel, Drivers and LVGL support
    * True black for amoled
    * BLE mocks until I get the controller board
    * Add rotation to T-Display
    * Add sleep/wakeup routines
    * Subclass CO5300 and add color order functions
    * Return correct ID in getModel
    * Remove S3-AMOLED board as it is identical to T-RGB
    * Add battery voltage reading (just in case)
    * Streamline board identification
    * Rearrange touch driver init
    * Fix typo
    * Fix samples read in getBattVoltage
    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
    [CO5300.cpp, CO5300.h, DefaultUI.cpp, LV_Helper.cpp, LilyGoTDisplayDriver.cpp, LilyGoTDisplayDriver.h, LilyGo_RGBPanel.h]
2025-07-27 Fix some bugs in T-Display code (#331)
    [LilyGo_TDisplayPanel.cpp]
2025-07-28 feat: Add back button to profile edit
2025-07-29 fix: Fix smoothing of flow
2025-07-29 fix: Try smooth down pressure control
2025-08-01 feat: Add headless target for ESP32-S3 XIAO and ESP32-S3 Supermini
2025-08-12 feat: Use flow control for steam on Pro
2025-08-12 fix: Debug steam flow
    [Controller.cpp]
2025-08-12 fix: Fix pump flow multiplier
    [Controller.cpp]
2025-08-12 fix: Fix reset logic for Waveshare 2.1 screen
    [WavesharePanel.cpp]
2025-08-12 fix: Add reset for touch driver
    [WavesharePanel.cpp]
2025-08-12 fix: Fix waveshare screen dimming
    [WavesharePanel.cpp, utilities.h]
2025-08-13 Add pump model settings to WebUI (#330)
    * Add pump model settings to WebUI
    * Remove old comment
    * Refactor pump model coefficients to use a 3rd order polynomial representation. Update related methods and BLE callbacks to accommodate new coefficient parameters. Adjust default values in settings and UI accordingly.
    * Enhance pump flow coefficient handling by adding a new method for setting flow coefficients in DimmedPump. Update GaggiMateController to differentiate between flow measurement and polynomial coefficients. Modify UI to reflect changes in input expectations for pump model coefficients.
    * Update pump flow polynomial coefficients for consistency with linear model
    * Update GaggiMa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
2025-08-13 Daisy UI Migration (#355)
    * Add Daisy Ui (#339)
    * Initial Daisy Ui transition and 4 themes to start
    * Update Ui
    * Fix SonarCloud issues
    * Remove Computed Single line Chart Register
    * Use JSX syntax
    * Apply Bunny Fixes
    * Use card component
    * Use Card
    * Fix active and hover states
    * Format and Style Nav Bar Better
    * Move profiles over(need to fix spacing between lables)
    * Fix Mobile Layout
    * Fix mobile layout
    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
    [WebUIPlugin.cpp]
2025-08-13 fix: Fix momentary buttonsg
    [Controller.cpp, Settings.cpp]
2025-08-14 Update BLEScalePlugin.cpp for Aliexpress myscale support (#353)
    * Update BLEScalePlugin.cpp for Aliexpress myscale support
    Added call to myscale Aliexprss cheap scale in conjunction with https://github.com/gaggimate/esp-arduino-ble-scales/pull/11
    * Fixed issue where the bluetooth scale was taring too late (at brew start).
    If the scale had a higher value than the voulumetric setpoint at start,
    the tare would not happen in time and the brew would finish.
    The controller now tares the bluetooth scale before starting the brew and at the same time as it issues controller->tare() to the hardware scale.
    [BLEScalePlugin.cpp, Controller.cpp]
2025-08-15 fix: Add web app manifest, fix estimated volume export
    [Controller.cpp]
2025-08-15 Add Flush to WebUI (#360)
    * Add Flush to WebUI
    * Pass isFlushing as a prop
    * Make flush button smaller and bellow brew button
    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
2025-08-17 Add advanced profiles (#365)
    * feat: Add schema changes for advanced profiles
    * feat: Add exit conditions and temperature profiling
    * feat: Separate process classes
    * chore: Reformat
    * feat: Add transitions
    * fix: Add code review feedback
    * fix: Allow bigger size profiles, allow foreign profile formats
    * feat: Extend web ui to allow editing pro profiles
    * fix: Fix new profile rendering
    * feat: Add decent profile import
    * fix: Don't ramp limit
    * fix: Fix profile chart
    * feat: Add transition and temperature config to UI
    * fix: Fix adaptive setting
    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
    [BLEScalePlugin.cpp, BoilerFillPlugin.cpp, BoilerFillPlugin.h, BrewProcess.h, Controller.cpp, Controller.h, DefaultUI.cpp, GrindProcess.h]
2025-08-17 fix: Fix phase temperature
2025-08-21 fix: Fix deleting cancelled shots, weight flow
    [BrewProcess.h, ShotHistoryPlugin.cpp]
2025-08-21 fix: Switch NTP logic
    [BrewProcess.h, DefaultUI.cpp, GrindProcess.h, ShotHistoryPlugin.cpp]
2025-08-21 fix: Treat temps as float
    [Controller.cpp, Controller.h, DefaultUI.cpp, HomekitPlugin.cpp, MQTTPlugin.cpp, Process.h, PumpProcess.h, SteamProcess.h]
2025-08-21 fix: Fix compile warnings
    [BrewProcess.h, Controller.cpp, GrindProcess.h, Process.h, ProfileManager.cpp, ProfileManager.h, ShotHistoryPlugin.cpp, WebUIPlugin.cpp]
2025-08-21 fix: Fix UI bugs, change phase targets
    [WebUIPlugin.cpp]
2025-08-21 feat: Add experimental outputs for flow estimation
2025-08-21 fix: Fix critical sonarqube issues
2025-08-21 fix: Optimize loading of profile selection
    [DefaultUI.cpp, DefaultUI.h, ProfileManager.cpp, ProfileManager.h]
2025-08-21 fix: Revert heating indicator to green/red
    [DefaultUI.cpp]
2025-08-21 fix: Fix difference between preview chart and execution
    [BrewProcess.h]
2025-08-21 fix: Remove duplicated code
    [DefaultUI.cpp, DefaultUI.h]
2025-08-21 feat: add mqtt auto discovery (#220)
    * add mqtt device discover to HA
    * get versions from controller
    * round temperature values
    * add Home Assistant topic on settings
    * add haTopic to api handler
    * add input field on settings page
    * remove hardcoded version
    * remove old config message
    * add topic storage and default value
    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
2025-08-21 fix: Cleanup mqtt changes
    [MQTTPlugin.cpp, MQTTPlugin.h]
2025-08-21 fix: Fix compile errors
    [Settings.cpp, Settings.h]
2025-08-22 Nayrod experimental (#376)
    * Update NayrodLab with lab equipment
    * Flow and coffee output estimation improvement. First drop synch
2025-08-22 Add move up/down functionality and persist profile order (#377)
    * Add move up/down functionality for profile cards
    * Persist reordering of profiles
    * Fix PR comments
    * Minor cleanup in Settings.cpp
    Makes the code a bit easier to read.
    * Add aria-disabled to move-buttons.
    [ProfileManager.cpp, Settings.cpp, Settings.h, WebUIPlugin.cpp]
2025-08-22 Return ordered favorites based on stored profile order (#381)
    * Update getFavoritedProfiles to return ordered favorites based on stored profile order
    * PR comments fix
    * Fix PR comment
    [ProfileManager.cpp]
2025-08-22 fix: Use either time or volumetric logic for standard profiles
    [BrewProcess.h, ProfileManager.cpp, Settings.cpp]
2025-08-22 feat: Allow steam pump cutoff to be configurable
2025-08-23 fix: Skip PWM logic for 0/100 setting of simple pump
2025-08-23 fix: Fix some process info bugs on web ui
    [WebUIPlugin.cpp]
2025-08-23 fix: Fix formatting of steam pump percentage field
2025-08-25 feat: Add convert to pro button
2025-08-25 fix: Fix string overflow in json serialization
    [WebUIPlugin.cpp]
2025-08-25 Shot history notes (#356)
    * Adds editable notes to the shot history feature, allowing users to add and view notes for each shot. The notes are stored in a JSON file alongside the shot history data and can be edited through a new UI component.
    The local export function also includes the notes in the exported JSON file.
    * Clean up duplicate code
    * Remove notes on deletion
    * Fix note saving
    * String declaration change
    * Better handling of note prefill and editing.
    * Include notes in json export
    * Export shot history with json export
    * Update history card on notes update
    [ShotHistoryPlugin.cpp, ShotHistoryPlugin.h]
2025-08-25 fix: Switch back to 250ms telemetry
    [ShotHistoryPlugin.cpp]
2025-08-25 fix: Fix variation between virtual scales and puck flow
2025-08-28 WifiManager v1.6.1: arm DHCP each retry; avoid radio power-off; fix precedence; disable sleep
    [WifiManager.cpp]
2025-09-03 wifi: add reconnect backoff and AP fallback - Track reconnect attempts with 3s delay between retries - Reset counter on GOT_IP to track connection attempts. - Switch to AP mode after 20x WIFI_CONNECT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
    [Controller.cpp]
2025-09-04 wifi: disable sleep on GOT_IP, trigger STA/AP connect events to prevent MQTT/HomeKit starting before IP
    [Controller.cpp]
